lpires211002/CHIDORI_Proyecto_final_de_carrera/Escrito PFC/figuras/bode_cadena.pdf

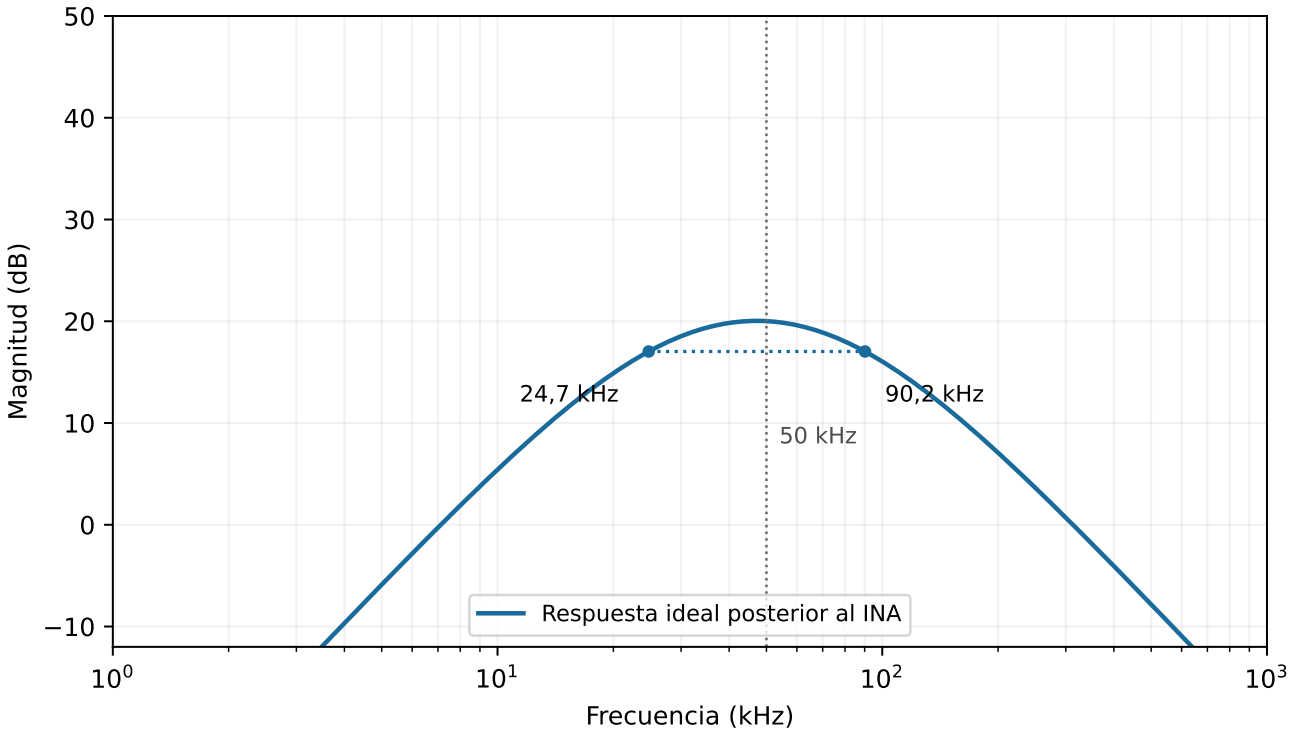
[picture p54: figure]
Frecuencia (kHz); Magnitud (dB); 24,7 kHz; 90,2 kHz; 50 kHz; Respuesta ideal; posterior al INA
