lpires211002/CHIDORI_Proyecto_final_de_carrera/Analisis_EDA/salidas/figuras/caida_por_sujeto.png

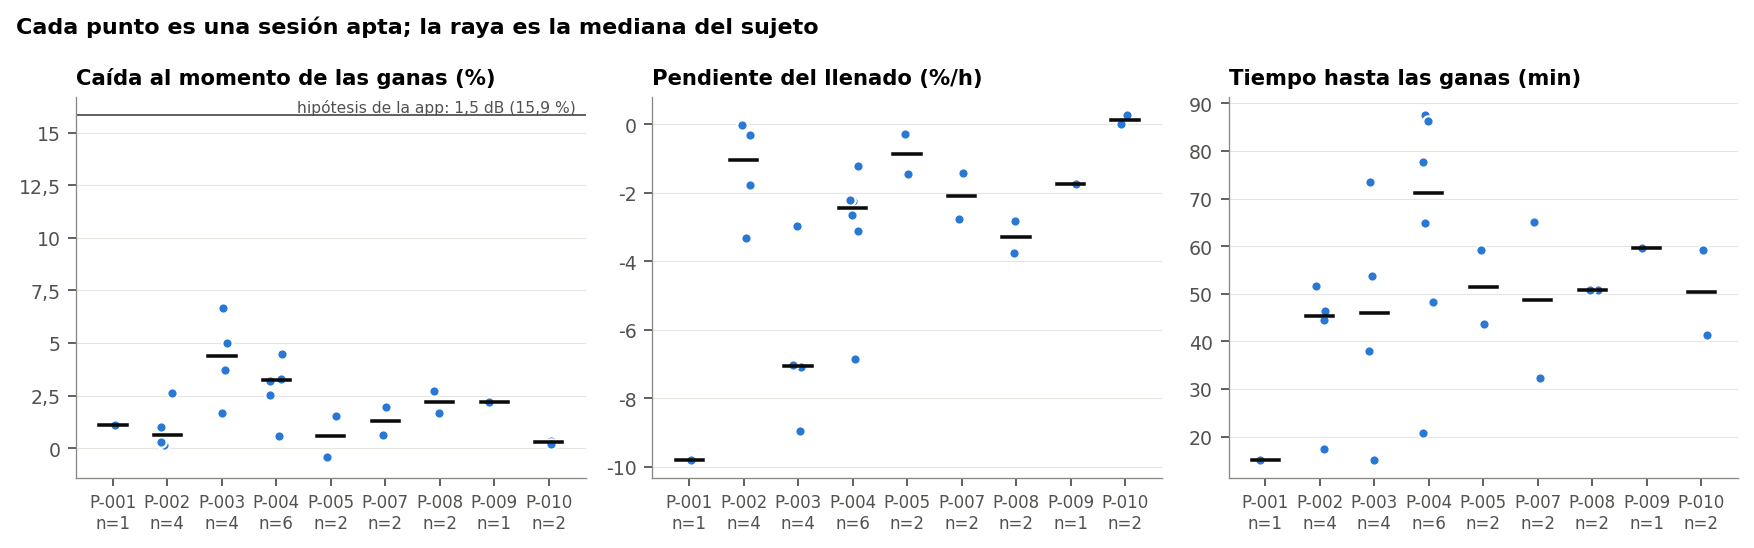
Analisis_EDA/salidas/figuras/caida_por_sujeto.png
