lpires211002/CHIDORI_Proyecto_final_de_carrera/Analisis_EDA/salidas/figuras/respuesta_tomas.png

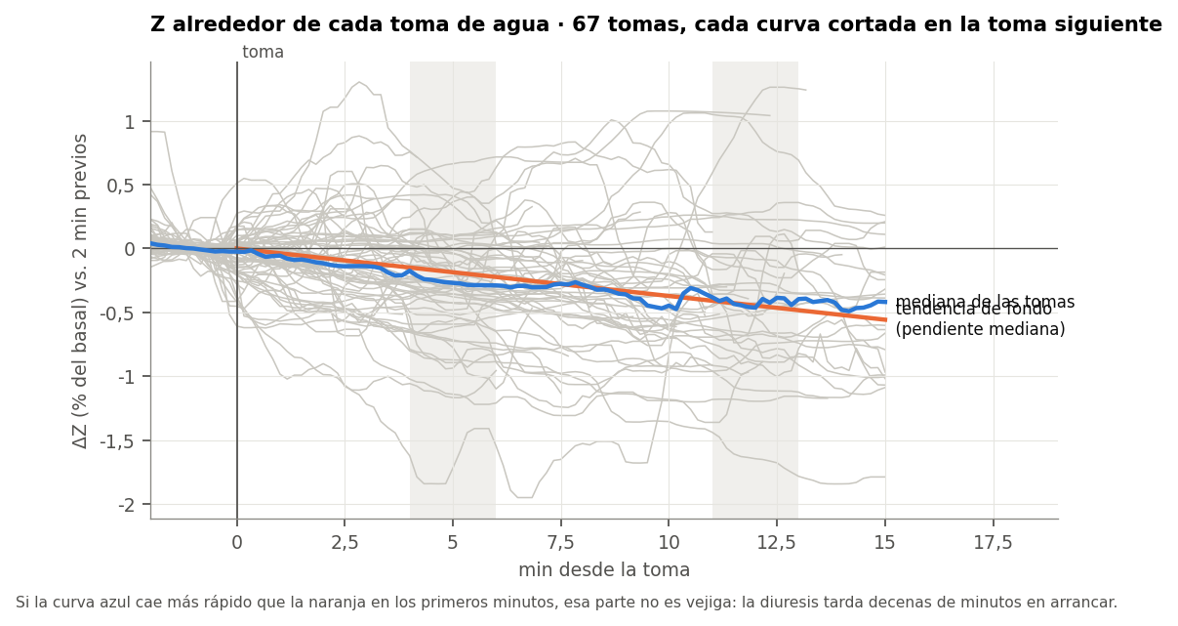
Analisis_EDA/salidas/figuras/respuesta_tomas.png
