lpires211002/CHIDORI_Proyecto_final_de_carrera/Analisis_EDA/salidas/figuras/sesiones/sesion_P-002_s05.png

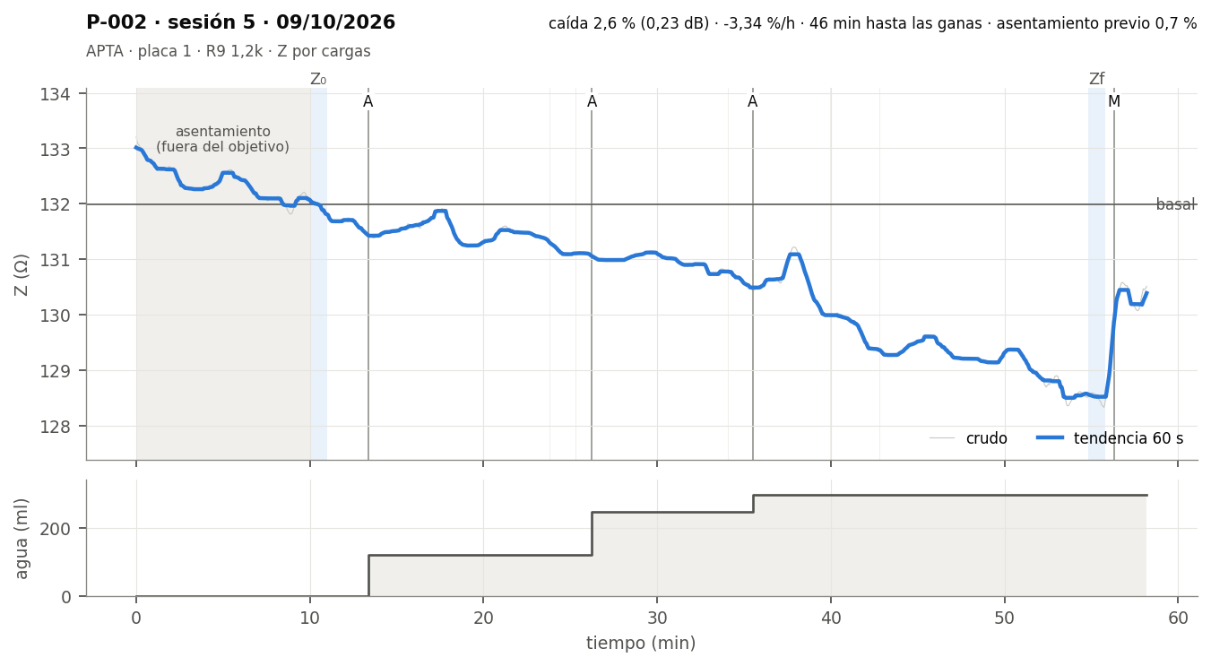
Analisis_EDA/salidas/figuras/sesiones/sesion_P-002_s05.png
