lpires211002/CHIDORI_Proyecto_final_de_carrera/Analisis_EDA/salidas/figuras/sesiones/sesion_P-004_s11.png

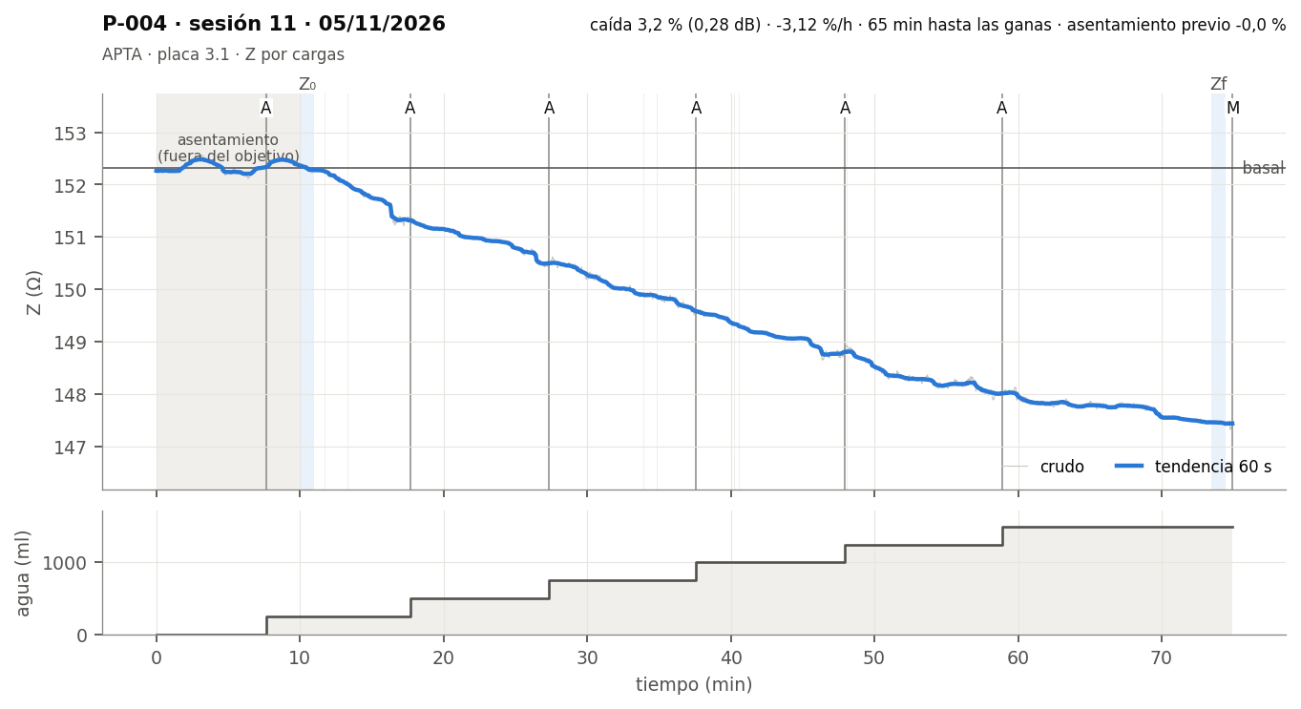
Analisis_EDA/salidas/figuras/sesiones/sesion_P-004_s11.png
