lpires211002/CHIDORI_Proyecto_final_de_carrera/Analisis_EDA/salidas/figuras/sesiones/sesion_P-004_sin_nro_95b01478.png

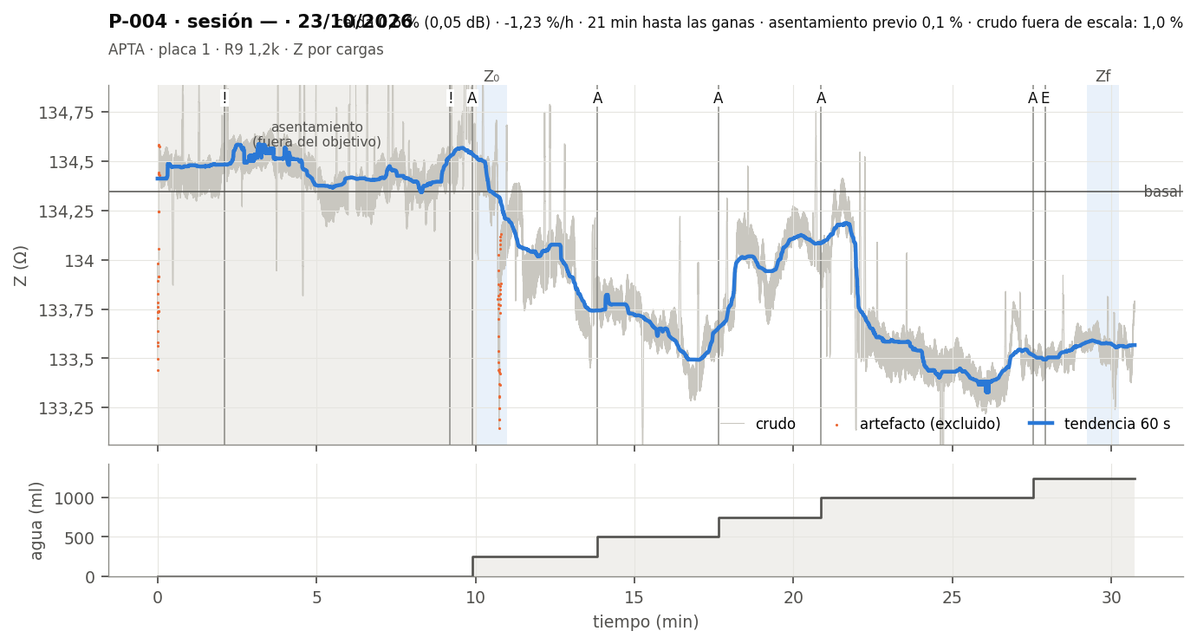
Analisis_EDA/salidas/figuras/sesiones/sesion_P-004_sin_nro_95b01478.png
