lpires211002/CHIDORI_Proyecto_final_de_carrera/Analisis_EDA/salidas/figuras/sesiones/sesion_P-005_s02.png

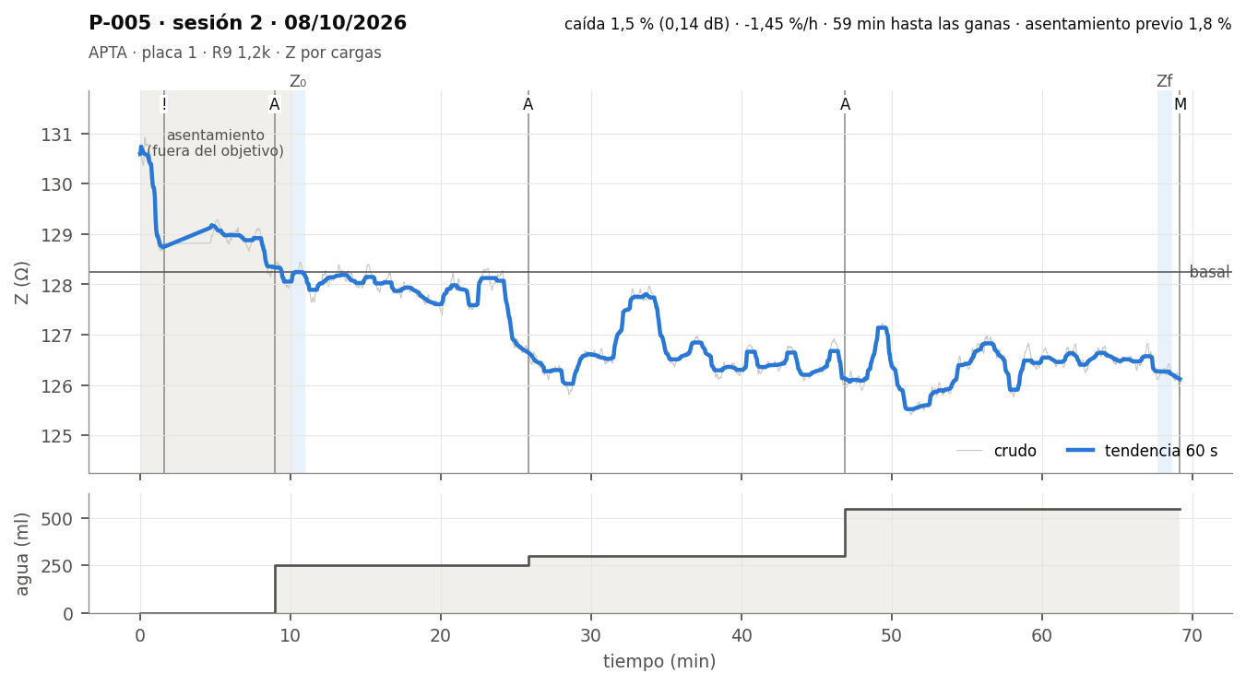
Analisis_EDA/salidas/figuras/sesiones/sesion_P-005_s02.png
