lpires211002/CHIDORI_Proyecto_final_de_carrera/Escrito PFC/diagramabloquespfc2.drawio.png

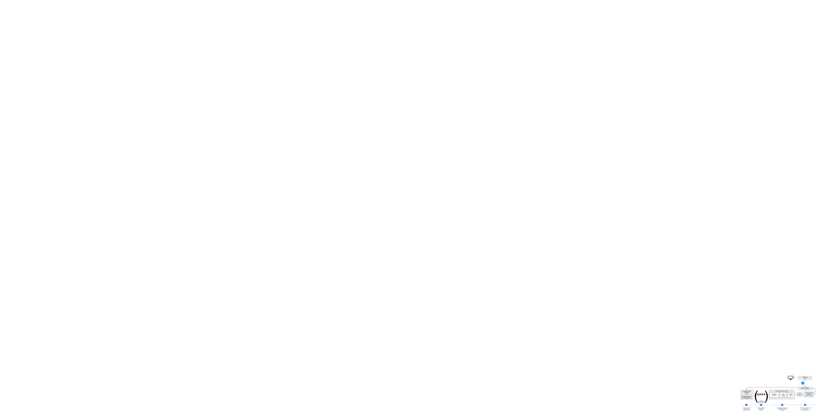
Escrito PFC/diagramabloquespfc2.drawio.png
