lpires211002/CHIDORI_Proyecto_final_de_carrera/Escrito PFC/diagramabloquespfc.drawio.png

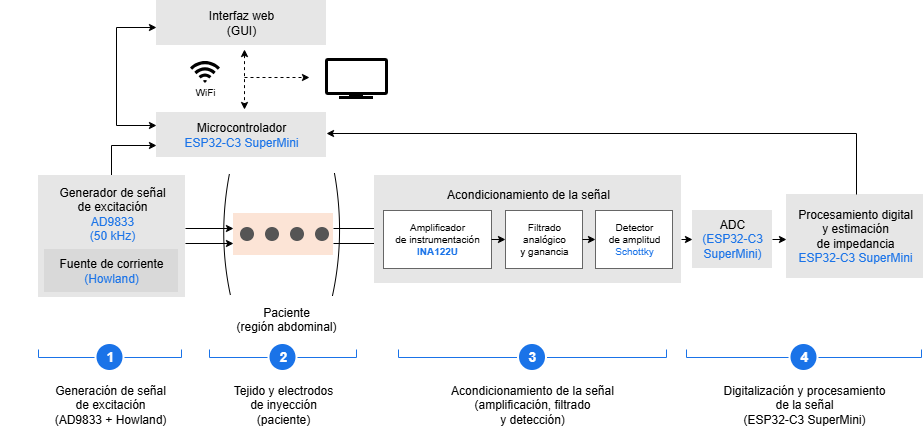
Escrito PFC/diagramabloquespfc.drawio.png
