lpires211002/CHIDORI_Proyecto_final_de_carrera/Escrito PFC/figuras/alrawi2013/realimentacion-corriente.png

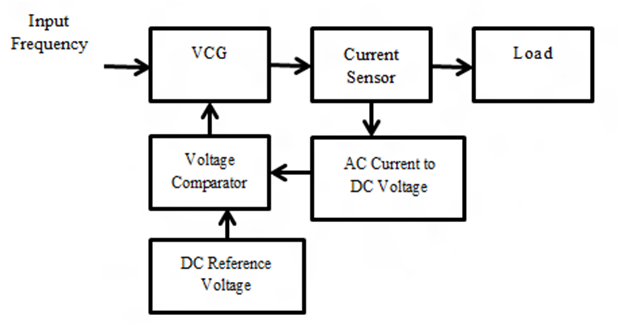
Escrito PFC/figuras/alrawi2013/realimentacion-corriente.png
