lpires211002/CHIDORI_Proyecto_final_de_carrera/Escrito PFC/figuras/bode_acondicionamiento.png

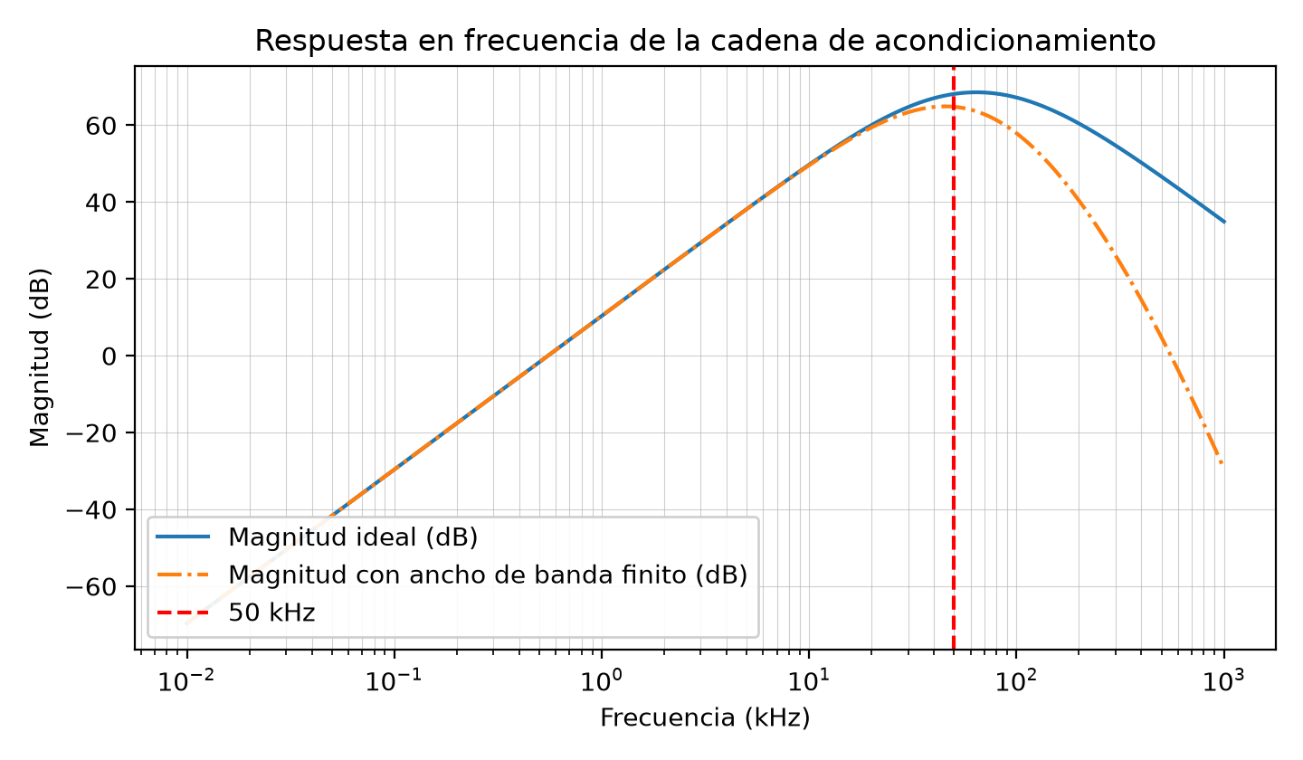
Escrito PFC/figuras/bode_acondicionamiento.png
