lpires211002/CHIDORI_Proyecto_final_de_carrera/Escrito PFC/figuras/bode_cadena.png

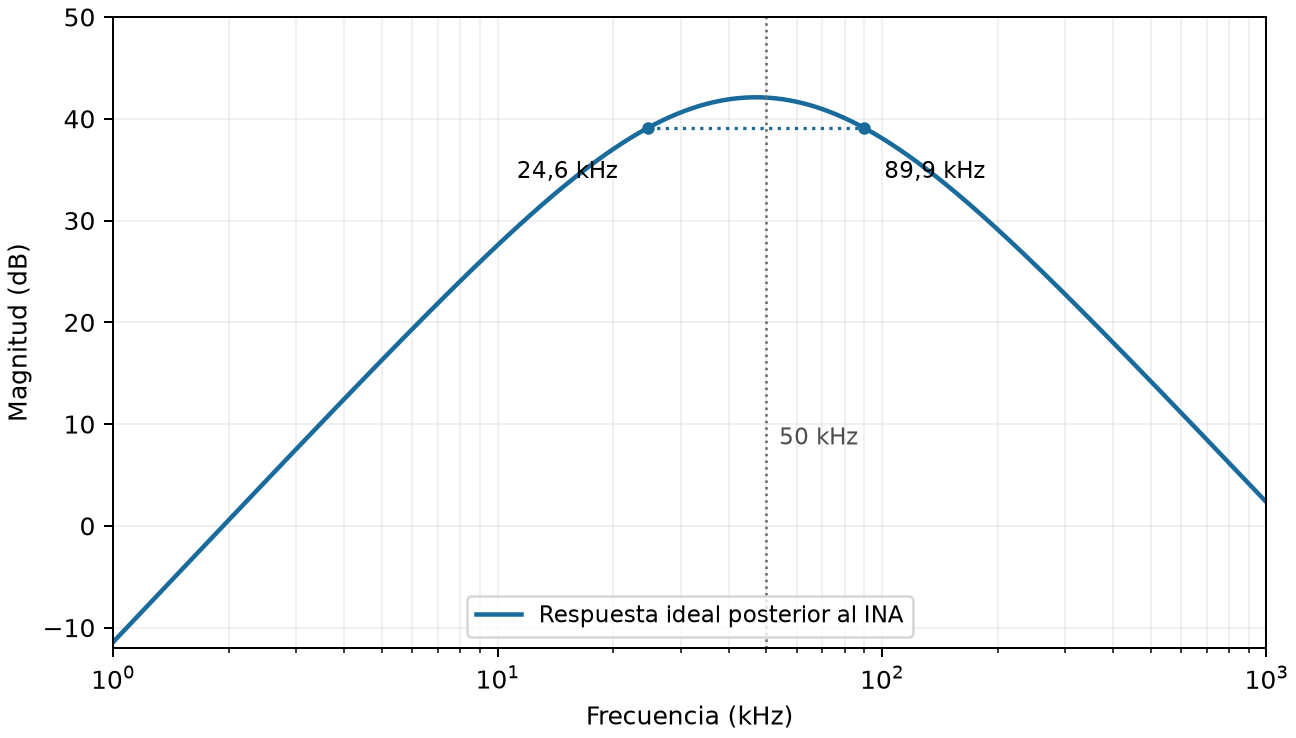
Escrito PFC/figuras/bode_cadena.png
