lpires211002/CHIDORI_Proyecto_final_de_carrera/Escrito PFC/figuras/der_base_datos.png

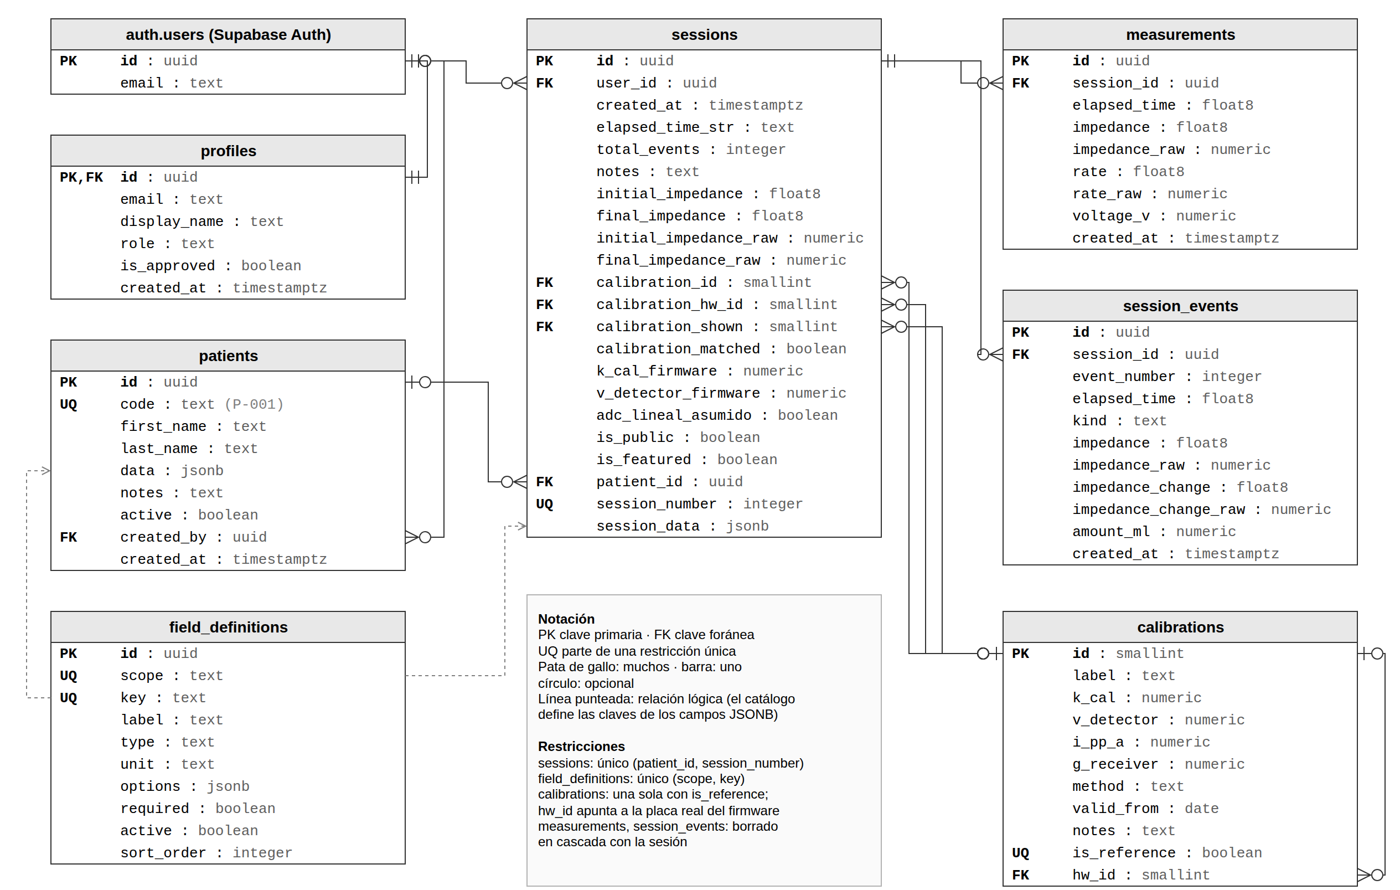
Escrito PFC/figuras/der_base_datos.png
