lpires211002/CHIDORI_Proyecto_final_de_carrera/Escrito PFC/figuras/esquema_preview.png

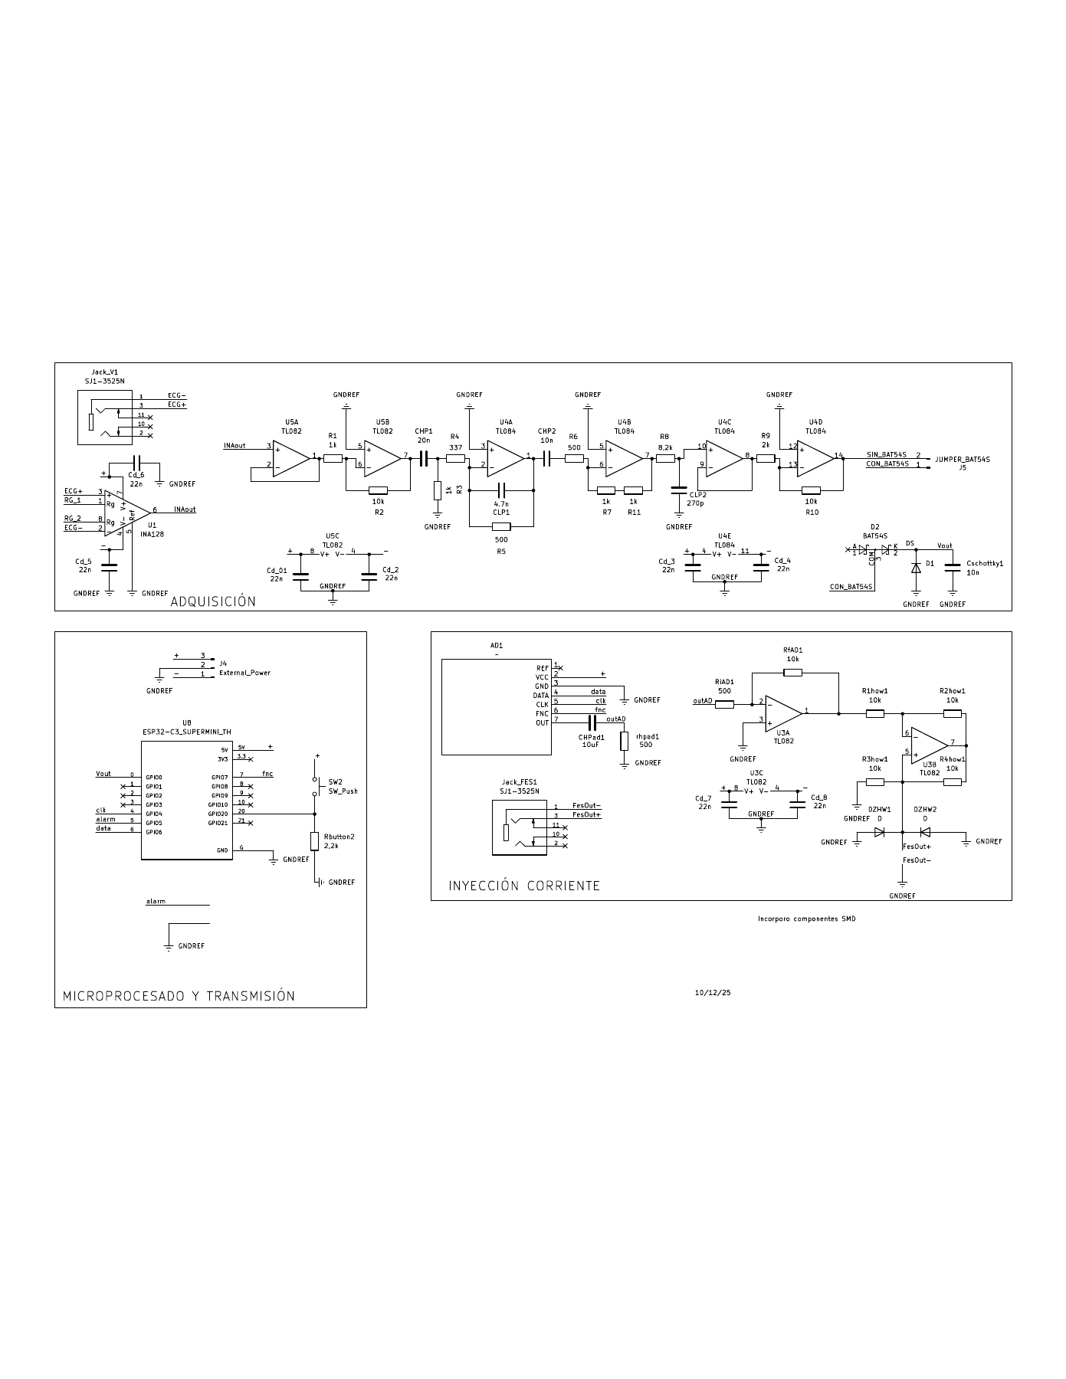
Escrito PFC/figuras/esquema_preview.png
