lpires211002/CHIDORI_Proyecto_final_de_carrera/PCB PFC/BOM_CHIDORI.xlsx

Sheet: BOM SMD (PCBWay)
# | Designadores | Cant. | Valor | Footprint | MPN sugerido (CONFIRMAR) | Notas
1 | CLP1 | 1 | 100p | C_0603 | Samsung CL10C101JB8NNNC | C0G/NP0 50V
2 | CLP2 | 1 | 270p | C_0603 | Samsung CL10C271JB8NNNC | C0G/NP0 50V
3 | CHP2 | 1 | 1.5n | C_0603 | Samsung CL10B152KB8NNNC | X7R 50V
4 | CHP1,Cschottky1 | 2 | 4.7n | C_0603 | Samsung CL10B472KB8NNNC | X7R 50V
5 | Cd_01,Cd_2,Cd_4,Cd_5,Cd_6,Cd_7,Cd_8 | 7 | 22n | C_0603 | Samsung CL10B223KB8NNNC | X7R 50V
6 | CHPad1 | 1 | 10uF | C_0603 | Samsung CL10A106KP8NNNC | X5R - confirmar tension >= alimentacion
7 | R1,R11,R3,R4,R7,R9,RiAD1 | 7 | 1k | R_0805 | Yageo RC0805FR-071KL | 1% 1/8W
8 | R1how1,R2,R2how1,R3how1,R4how1,R8 | 6 | 10k | R_0805 | Yageo RC0805FR-0710KL | 1% 1/8W
9 | Rbutton2 | 1 | 2.2k | R_0805 | Yageo RC0805FR-072K2L | 1% 1/8W
10 | R5 | 1 | 22k | R_0805 | Yageo RC0805FR-0722KL | 1% 1/8W
11 | R10 | 1 | 4.7k | R_0805 | Yageo RC0805FR-074K7L | 1% 1/8W
12 | RfAD1 | 1 | 4.8k | R_0805 | RC0805FR-074K75L (4.75k) | VALOR RARO: 4.8k no existe. Confirmar 4.7k o 4.75k
13 | R6,rhpad1 | 2 | 500 | R_0805 | RC0805FR-07499RL (499R) | VALOR RARO: 500 no estandar. Usar 499R o 510R
14 | U1 | 1 | INA128 | SOIC-8 | TI INA128UA (o INA128U/2K5) | Inst. amp - confirmar MPN exacto
15 | U3,U5 | 2 | TL082 | SOIC-8 | TI TL082CDR | Op-amp dual
16 | U4 | 1 | TL084 | SOIC-14 | TI TL084CDR | Op-amp cuadruple
17 | D2 | 1 | BAT54S | SOT-23 | Diodes BAT54S-7-F | Schottky dual
 | TOTAL | 37

Sheet: THT (vos - NO a PCBWay)
Ref | Descripcion | Cant. | Que comprar / nota
U8 | Modulo ESP32-C3 Supermini | 1 | Comprar modulo ESP32-C3 Supermini (va sobre tiras de pin)
AD1 | Modulo AD9833 / CJMCU-9833 | 1 | Comprar modulo generador DDS AD9833 (CJMCU-9833)
Jack_FES1 | Jack 3.5mm SJ1-3525N | 1 | CUI SJ1-3525N
Jack_V1 | Jack 3.5mm SJ1-3525N | 1 | CUI SJ1-3525N
J4 | Conector alimentacion JST EH 3p | 1 | JST B3B-EH-A (vertical, paso 2.5mm)
J5 | Jumper 1x2 | 1 | Header 1x2 2.54mm + jumper
BZ1 | Buzzer 12mm RM7.6 | 1 | Confirmar activo vs pasivo segun tu circuito
SW2 | Pulsador tactil 6mm | 1 | Push button 6mm THT
D1 | Diodo DO-35 | 1 | VALOR 'DS' poco claro: confirmar (p.ej. 1N4148?)
DZHW1 | Diodo DO-35 | 1 | VALOR 'D' poco claro: confirmar (zener? tension?)
DZHW2 | Diodo DO-35 | 1 | VALOR 'D' poco claro: confirmar (zener? tension?)
