lpires211002/CHIDORI_Proyecto_final_de_carrera/PCB PFC/INA122U-2/INA122U.step

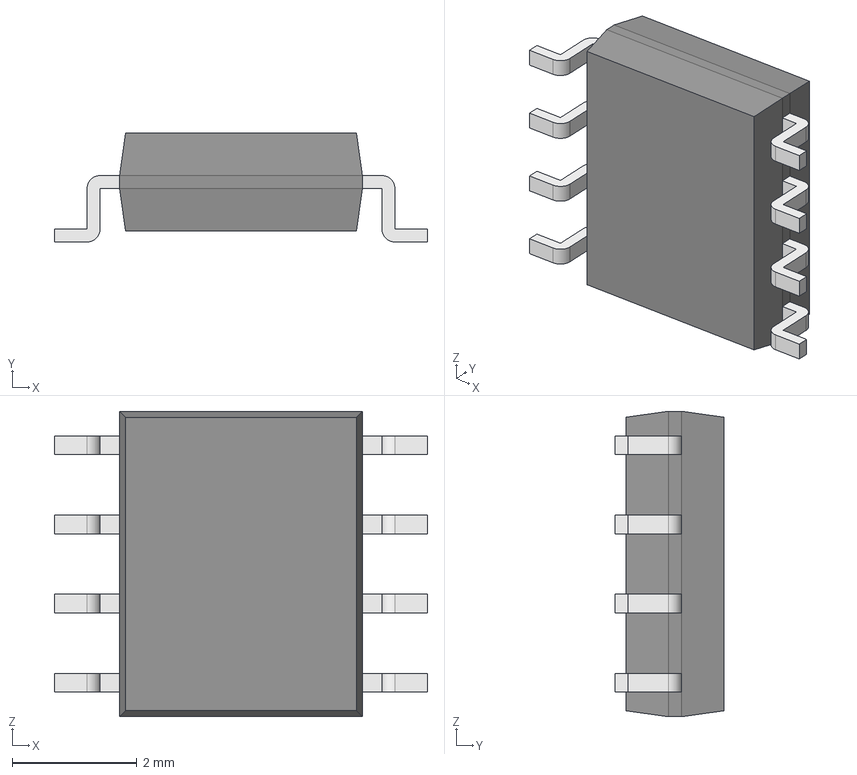
[picture p100: CAD file, 2025-11-30]
PCB PFC/INA122U-2/INA122U.step
5.99 x 1.75 x 4.91 mm
Body001 (Mirror #1) x 4
XY-plane x 12
X-axis x 12
