lpires211002/CHIDORI_Proyecto_final_de_carrera/Analisis_EDA/etiquetas_manuales.csv

session_id | paciente | nro_sesion | fecha | protocolo | sitio | apta | motivo_manual | fin_sesion | t_basal_s | notas_analisis | auto_protocolo | auto_apta | auto_motivos | auto_fin_sesion
dedda0d1-a155-4414-b714-fa066815543b | P-001 | 1 | 2026-08-06 |  |  |  |  |  |  |  | libre | si | cal_no_confirmada | ganas
a0fbf72f-a9fb-41bf-b0b5-ce43bacd0cf8 | P-002 | 1 | 2026-08-02 |  |  |  |  |  |  |  | libre | no | escalones;fin_con_artefactos;posible_prueba;adc_lineal;cal_no_confirmada | ganas
120878ab-8c2c-46b5-9122-46ee4540ab59 | P-002 | 2 | 2026-08-31 |  |  |  |  |  |  |  | libre | si | sin_tomas_registradas;cal_no_confirmada | ganas
f9907666-3603-4faa-a4bf-677e94b35c05 | P-002 | 3 | 2026-10-02 |  |  |  |  |  |  |  | libre | si |  | ganas
e79d53ec-db4d-46ef-b904-1582722755c2 | P-002 | 4 | 2026-10-09 |  |  |  |  |  |  |  | libre | si |  | ganas
ebfc117e-e6e3-48f0-b27e-2be2e4a54d51 | P-002 | 5 | 2026-10-09 |  |  |  |  |  |  |  | libre | si |  | ganas
a08e91ea-60f2-4cb5-9c7c-f09d39bcf85b | P-003 | 1 | 2026-08-15 |  |  |  |  |  |  |  | libre | no | basal_con_artefactos;sin_basal;llenado_corto;sin_tomas_registradas;cal_no_confirmada;muy_corta | ganas
d761b5a1-9ca9-4435-9ab0-fc307bc667e5 | P-003 | 2 | 2026-08-15 |  |  |  |  |  |  |  | libre | no | llenado_corto;cal_no_confirmada | ganas
1c9319bf-26fd-436f-b8fe-de8f2b1d8069 | P-003 | 3 | 2026-08-21 |  |  |  |  |  |  |  | libre | si | sin_tomas_registradas;cal_no_confirmada | ganas
96e77864-f66b-4d30-9c36-46c708f74876 | P-003 | 4 | 2026-08-30 |  |  |  |  |  |  |  | libre | si | sin_tomas_registradas;cal_no_confirmada | ganas
509b2c81-0ebc-4219-80d1-281b79a169f2 | P-003 | 5 | 2026-10-18 |  |  |  |  |  |  |  | libre | si |  | ganas
9b75903e-2d35-45ee-b4c7-bb318242ebbf | P-003 | 6 | 2026-10-30 |  |  |  |  |  |  |  | libre | si |  | ganas
f0827cfe-234e-4d3c-a13f-74073701dff5 | P-003 |  | 2026-07-26 |  |  |  |  |  |  |  | libre | no | sin_tomas_registradas;adc_lineal;cal_no_confirmada | ganas
79758fbc-a7d0-446c-8385-4123ff55b11c | P-004 | 1 | 2026-08-18 |  |  |  |  |  |  |  | libre | si | escalones;basal_con_artefactos;fin_con_artefactos;sin_tomas_registradas;cal_no_confirmada;integridad_baja | ganas
4d7bfcba-5a1a-417a-bb86-5d54055a7391 | P-004 | 5 | 2026-09-02 |  |  |  |  |  |  |  | libre | si | sin_tomas_registradas;cal_no_confirmada | ganas
4570b3e2-c1f8-4a0f-a355-aacb61dfb2c0 | P-004 | 7 | 2026-09-25 |  |  |  |  |  |  |  | libre | si | escalones | ganas
fa2e50e8-252a-4994-aab7-d22f37a2d8a9 | P-004 | 9 | 2026-09-27 |  |  |  |  |  |  |  | libre | si |  | ganas
5765473f-45b0-44d5-93a2-fbe87b1eda4e | P-004 | 10 | 2026-10-08 |  |  |  |  |  |  |  | libre | si |  | ganas
49cced3b-ff9c-4104-9c76-f8ff4bb96db7 | P-004 | 11 | 2026-11-05 |  |  |  |  |  |  |  | libre | si |  | ganas
95b01478-a18f-4ea6-9dd7-b72324e25a7c | P-004 |  | 2026-10-23 |  |  |  |  |  |  |  | libre | si |  | ganas
c27e2bd5-511c-4d4c-accd-2804eb0ab9c9 | P-005 | 1 | 2026-10-08 |  |  |  |  |  |  |  | libre | si |  | ganas
5804c4f6-6fd5-468a-bc45-c8129363ed7c | P-005 | 2 | 2026-10-08 |  |  |  |  |  |  |  | libre | si |  | ganas
2867c98b-8ed6-4346-9ba2-af4adc05e89a | P-006 | 1 | 2026-10-10 |  |  |  |  |  |  |  | libre | no | llenado_corto;muy_corta | ganas
ef2d70cb-c6cf-4ab8-a558-69dcf3c11057 | P-006 | 2 | 2026-10-26 |  |  |  |  |  |  |  | libre | si |  | ganas
f0852f01-d280-4d70-acb5-b8cc4febbf8e | P-007 | 1 | 2026-10-10 |  |  |  |  |  |  |  | libre | si |  | ganas
02ce5364-1276-4bb8-9cee-ba1e887510cd | P-007 | 3 | 2026-10-18 |  |  |  |  |  |  |  | libre | si |  | ganas
fc52a3be-a132-4365-924c-0b371e5f183a | P-008 | 1 | 2026-10-15 |  |  |  |  |  |  |  | libre | si |  | ganas
54be7662-83ef-42ab-85a3-3e46b8d3f2d4 | P-008 | 3 | 2026-10-24 |  |  |  |  |  |  |  | libre | si |  | ganas
21d20758-d9a3-4d25-80ad-712a764d2d04 | P-008 | 4 | 2026-10-28 |  |  |  |  |  |  |  | libre | no | llenado_corto | ganas
8a706da8-0d33-495f-a0dd-1e379090a9c2 | P-009 | 1 | 2026-10-21 |  |  |  |  |  |  |  | libre | no | duplicada | ganas
be1868dc-03eb-49ad-8cdc-f68b0c234be7 | P-009 | 4 | 2026-10-21 |  |  |  |  |  |  |  | libre | si |  | ganas
a6806f88-9787-4ac0-b927-7ace5e4ca1ae | P-009 | 5 | 2026-11-04 |  |  |  |  |  |  |  | libre | si | fin_con_artefactos | ganas
ae20aecf-c65f-4018-aaba-1392ced1a784 | P-010 | 1 | 2026-10-26 |  |  |  |  |  |  |  | libre | si |  | ganas
03d236cb-49d3-4edf-a545-cf1af9c8d1fd | P-010 | 2 | 2026-11-04 |  |  |  |  |  |  |  | libre | si |  | ganas
