lpires211002/CHIDORI_Proyecto_final_de_carrera/Programacion_UI_Micro/UI_VIEJA/PRUEBA_UI/1. Prueba_inicial/index.html

⚡

# Chidori

Inactivo

## Control de Mediciones

Monitoreo de bioimpedancia en tiempo real

▶ Iniciar Mediciones 📍 Marcar Evento ↻ Reiniciar ⬇ Descargar Datos

Valor Inicial

Ω

Valor Actual

Ω

Tiempo Transcurrido

00:00

min:seg

Eventos Marcados

0

marcadores

## Gráfica de Impedancia

Módulo de impedancia vs tiempo

⚙️ Configuración de Alarmas ›

Activar sistema de alarmas

Valor absoluto de impedancia

Porcentaje del valor inicial

Diferencia respecto al inicial

## Información del Paciente

×

Nombre Completo

Edad

Sexo

Masculino Femenino

Peso (kg)

Altura (m)

Circunferencia Suprailíaca (cm)

Tiempo desde la última menstruación

Descargar solo mediciones ⬇ Descargar con datos completos
