lpires211002/CHIDORI_Proyecto_final_de_carrera/Escrito PFC/figuras/resultados_medicion_circuito.pdf

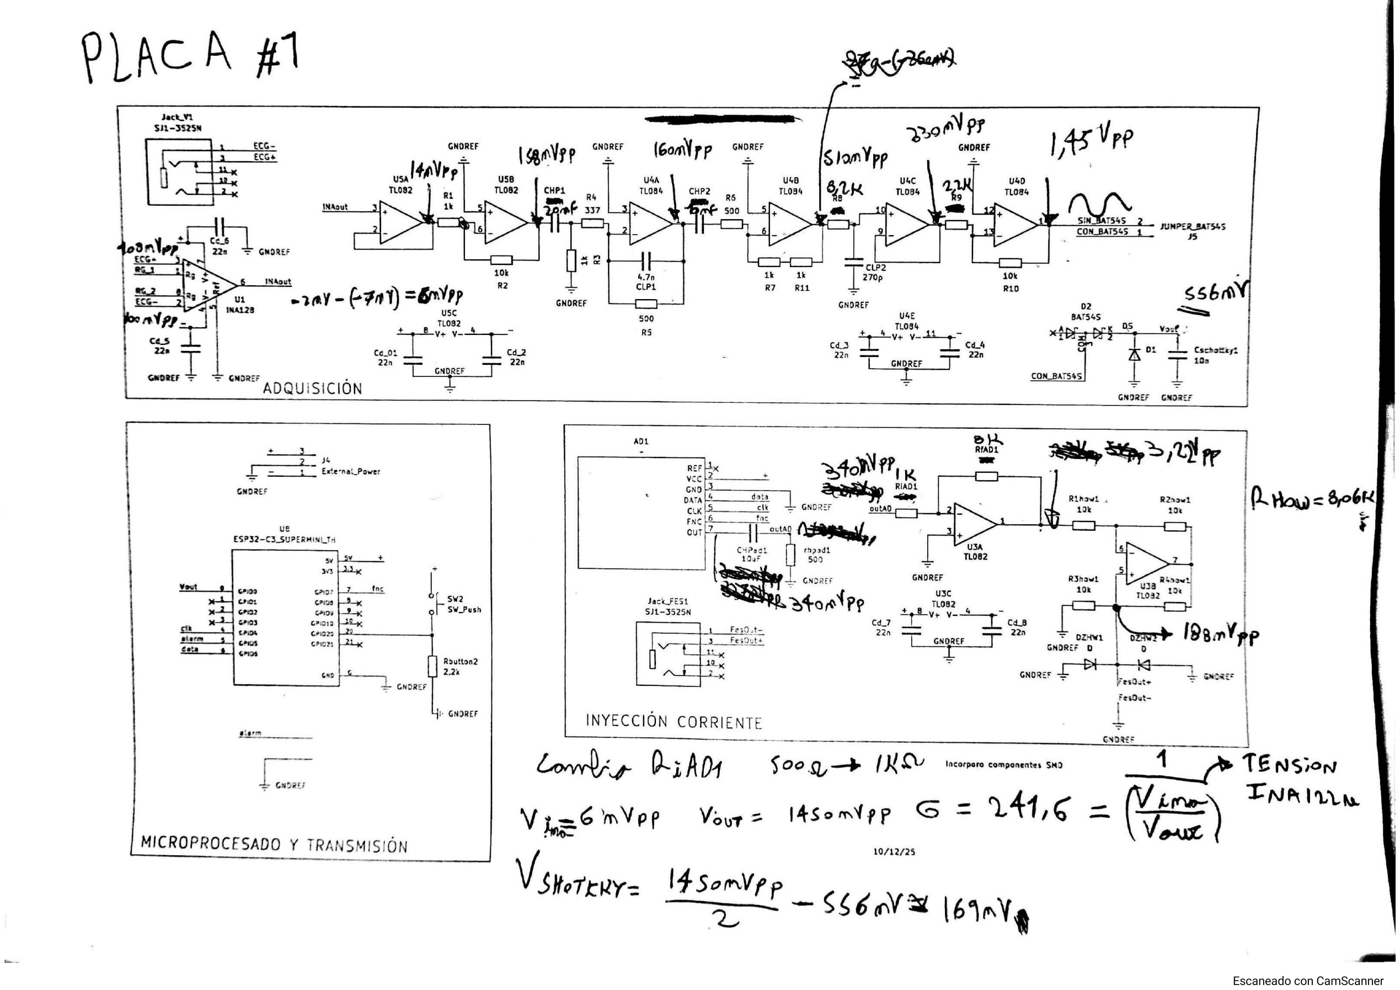
[picture p101: page 1]
