lpires211002/CHIDORI_Proyecto_final_de_carrera/Escrito PFC/figuras/cargas_respuesta.pdf

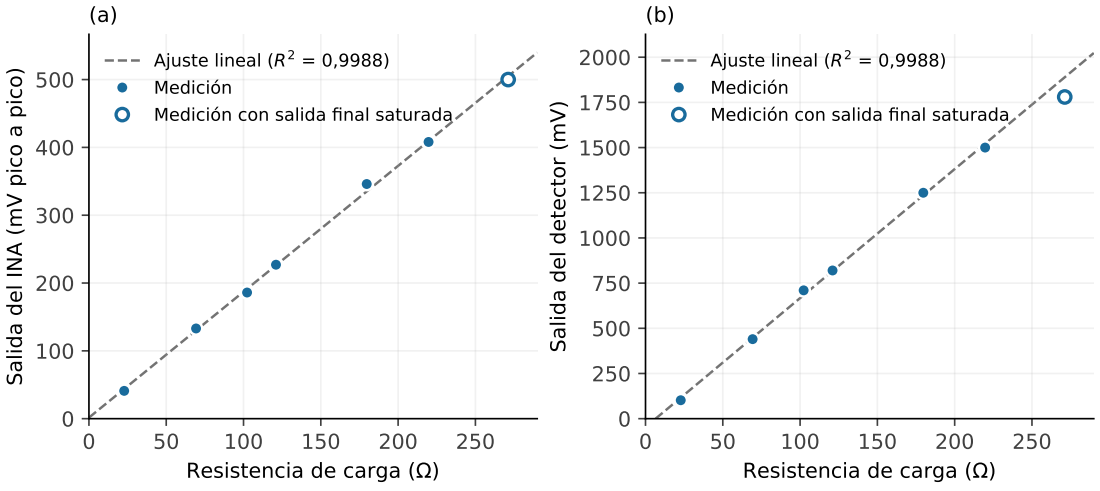
[picture p102: page 1]
Ajuste lineal (R

Salida del INA (mV pico a pico)

Medición
Medición con salida final saturada

Salida del detector (mV)

Resistencia de carga (Ω)
