lpires211002/CHIDORI_Proyecto_final_de_carrera/Escrito PFC/placadef1.pdf

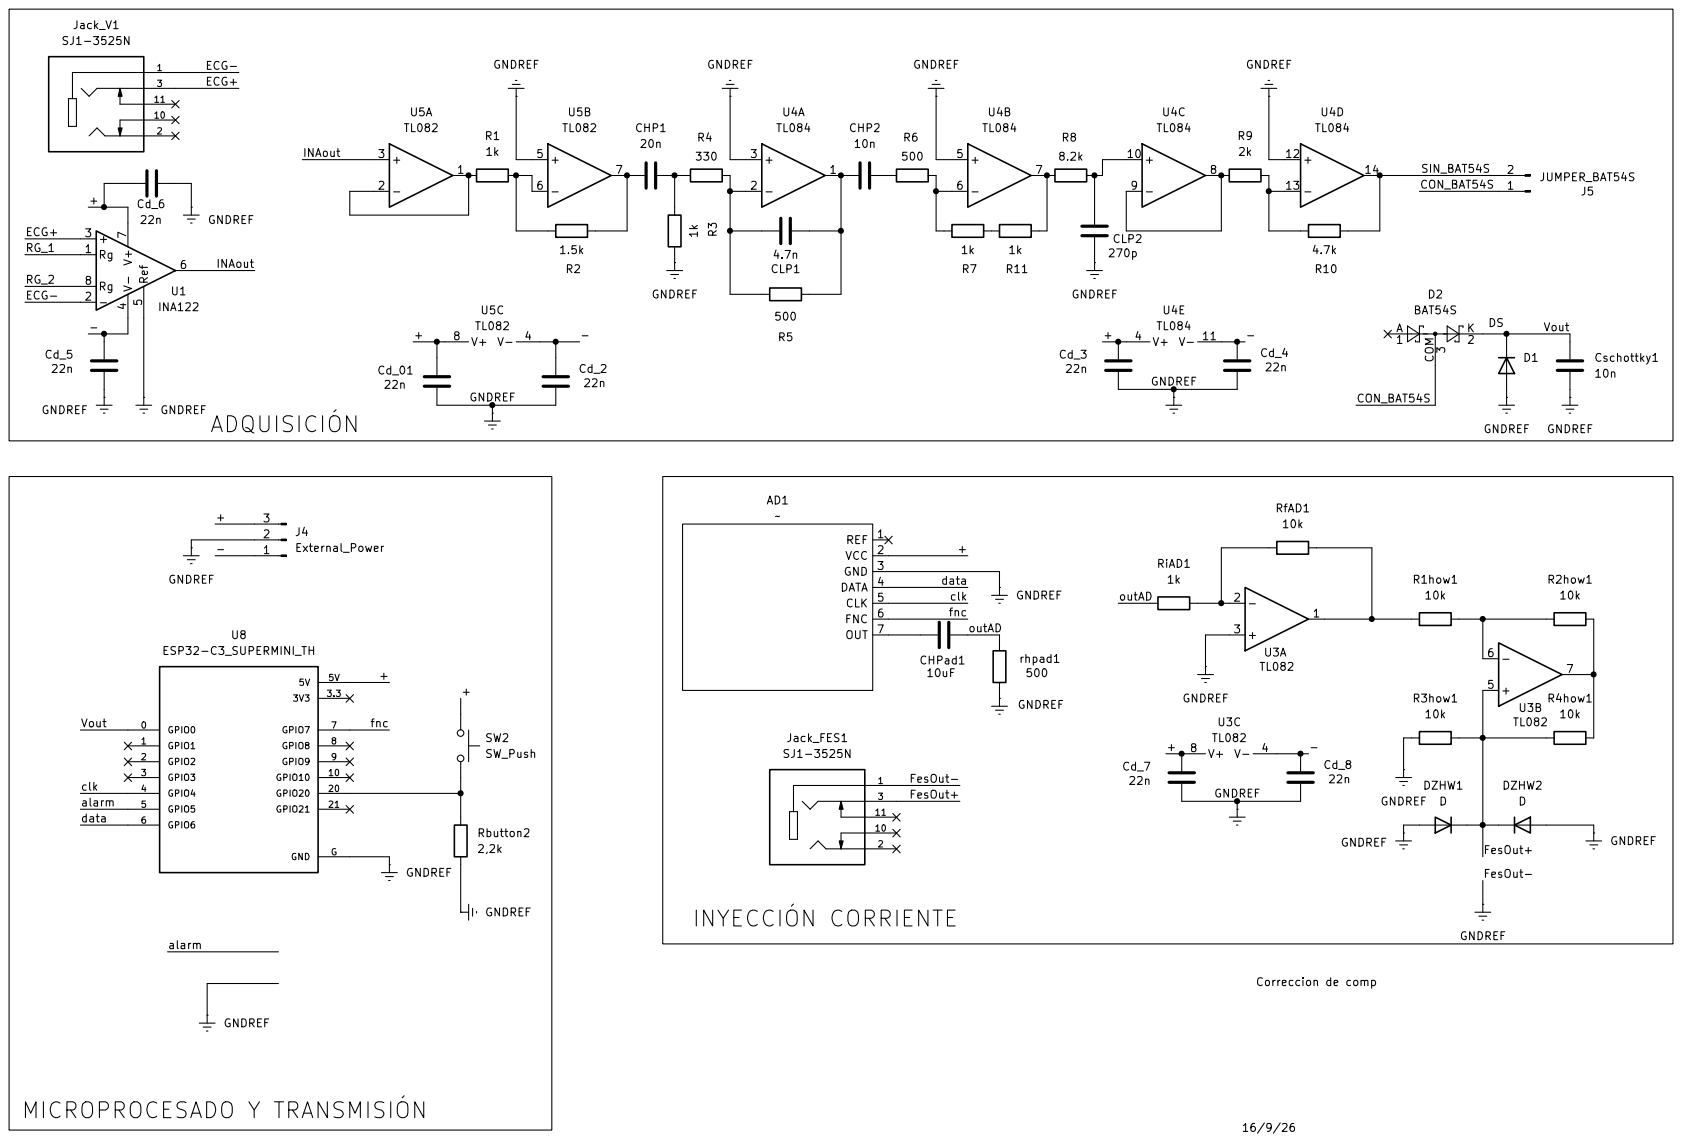
[picture p103: page 1]
