lpires211002/CHIDORI_Proyecto_final_de_carrera/Escrito PFC/figuras/electrodos_posicion.pdf

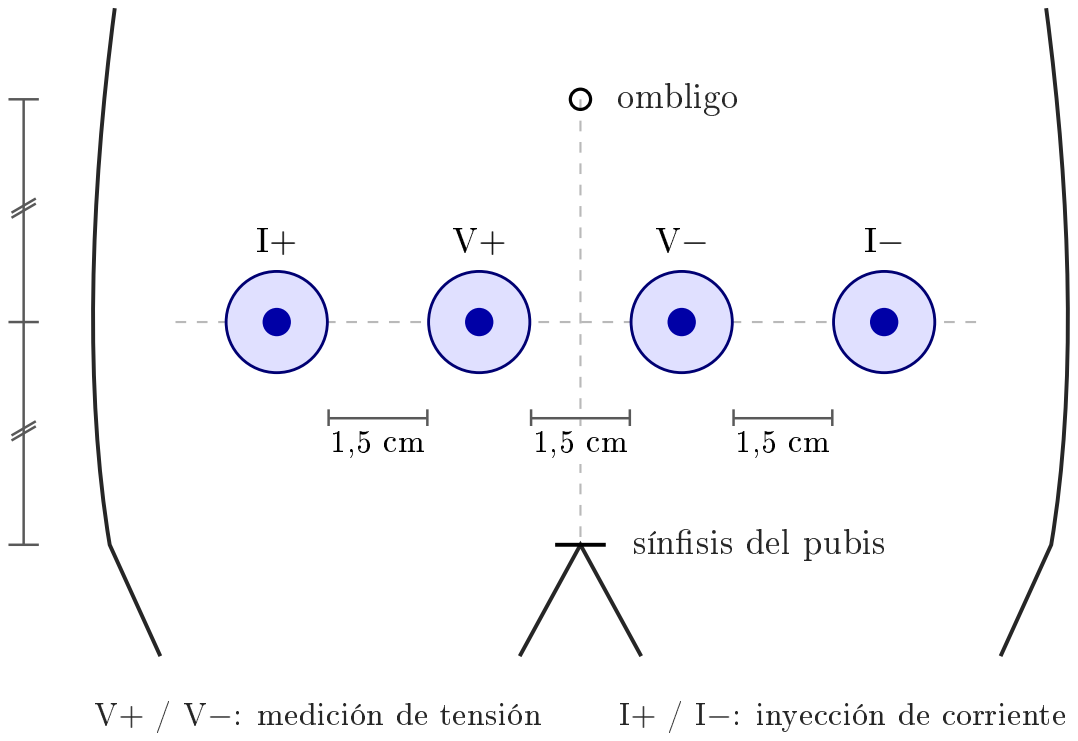
[picture p104: page 1]
ombligo; V+ / V−: medición de tensión; I+ / I−: inyección de corriente

sínsis del pubis
