lpires211002/CHIDORI_Proyecto_final_de_carrera/Escrito PFC/figuras/esquema_circuito.pdf

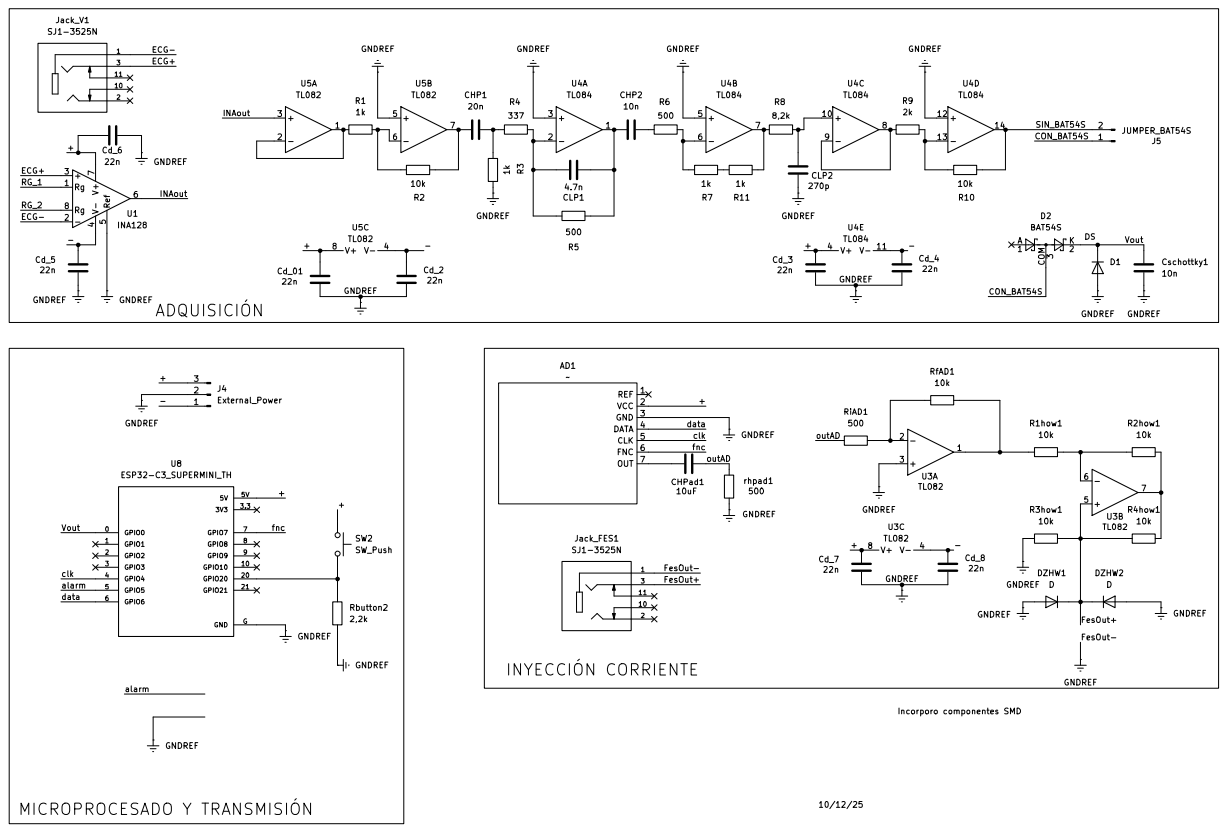
[picture p105: page 1]
