lpires211002/CHIDORI_Proyecto_final_de_carrera/LTspice/Filtrado actual.asc

C1: Cap; 4.7n
C2: Cap; 4.7n
C3: Cap; 1.5n
C4: Cap; 270p
C5: Cap; 10n
D1: schottky
R1: Res; 1k
R2: Res; 1k
R3: Res; 510
R4: Res; 500
R5: Res; 2k
R6: Res; 10k
R7: Res; 510
R8: Res; 16.2k
R9: Res; 1k
R10: Res; 0
R11: Res; 10k
R12: Res; 510
R13: Res; 22k
R14: Res; 10k
R15: Res; 10k
R16: Res; 10k
R17: Res; 10k
R18: Res; 10k
U1: LT1057
U2: LT1057
U3: LT1057
U4: LT1057
U5: LT1057
U6: LT1057
U7: LT1057
V1: Voltage; SINE(0 0.0010 50k)
V2: Voltage; 3.7
V3: Voltage; 3.7
V4: Voltage; SINE(0 0.75 50k)
Named nets: 0, a, b
.tran 1ms
