lpires211002/CHIDORI_Proyecto_final_de_carrera/LTspice/Idea Filtrado.asc

C5: Cap; 4.7n
C6: Cap; 100p
C7: Cap; 1.5n
C8: Cap; 270p
C17: Cap; 100n
C18: Cap; 100p
C19: Cap; 1.8n
C20: Cap; 220p
C21: Cap; 4.7n
C22: Cap; 1n
D1: schottky
D2: schottky
R1: Res; 10k
R12: Res; 1k
R13: Res; 1k
R14: Res; 22k
R15: Res; 500
R16: Res; 2k
R17: Res; 10k
R18: Res; 1k
R19: Res; 4.7k
R21: Res; 1k
R22: Res; 2.2k
R31: Res; 50
R37: Res; 1k
R38: Res; 22k
R39: Res; 500
R40: Res; 2.2k
R41: Res; 11k
R42: Res; 1k
R43: Res; 4k
R44: Res; 10k
R45: Res; 1k
R46: Res; 2.2k
U7: LT1057
U8: LT1057
U9: LT1057
U10: LT1057
U11: LT1057
U12: LT1057
U19: LT1057
U20: LT1057
U21: LT1057
U22: LT1057
U23: LT1057
U24: LT1057
V1: Voltage; SINE(0 0.15 3)
V5: Voltage; SINE(0 0.15 50k)
V6: Voltage; 3.7
V7: Voltage; 3.7
V9: Voltage; SINE(0 6m 50k)
V12: Voltage; SINE(0 2m 10k)
Named nets: 0, a, b
.tran 100ms
