lpires211002/CHIDORI_Proyecto_final_de_carrera/PCB PFC/PCB PFC.kicad_pcb

## KiCad design PCB PFC/PCB PFC.kicad_pcb (2026-06-26)

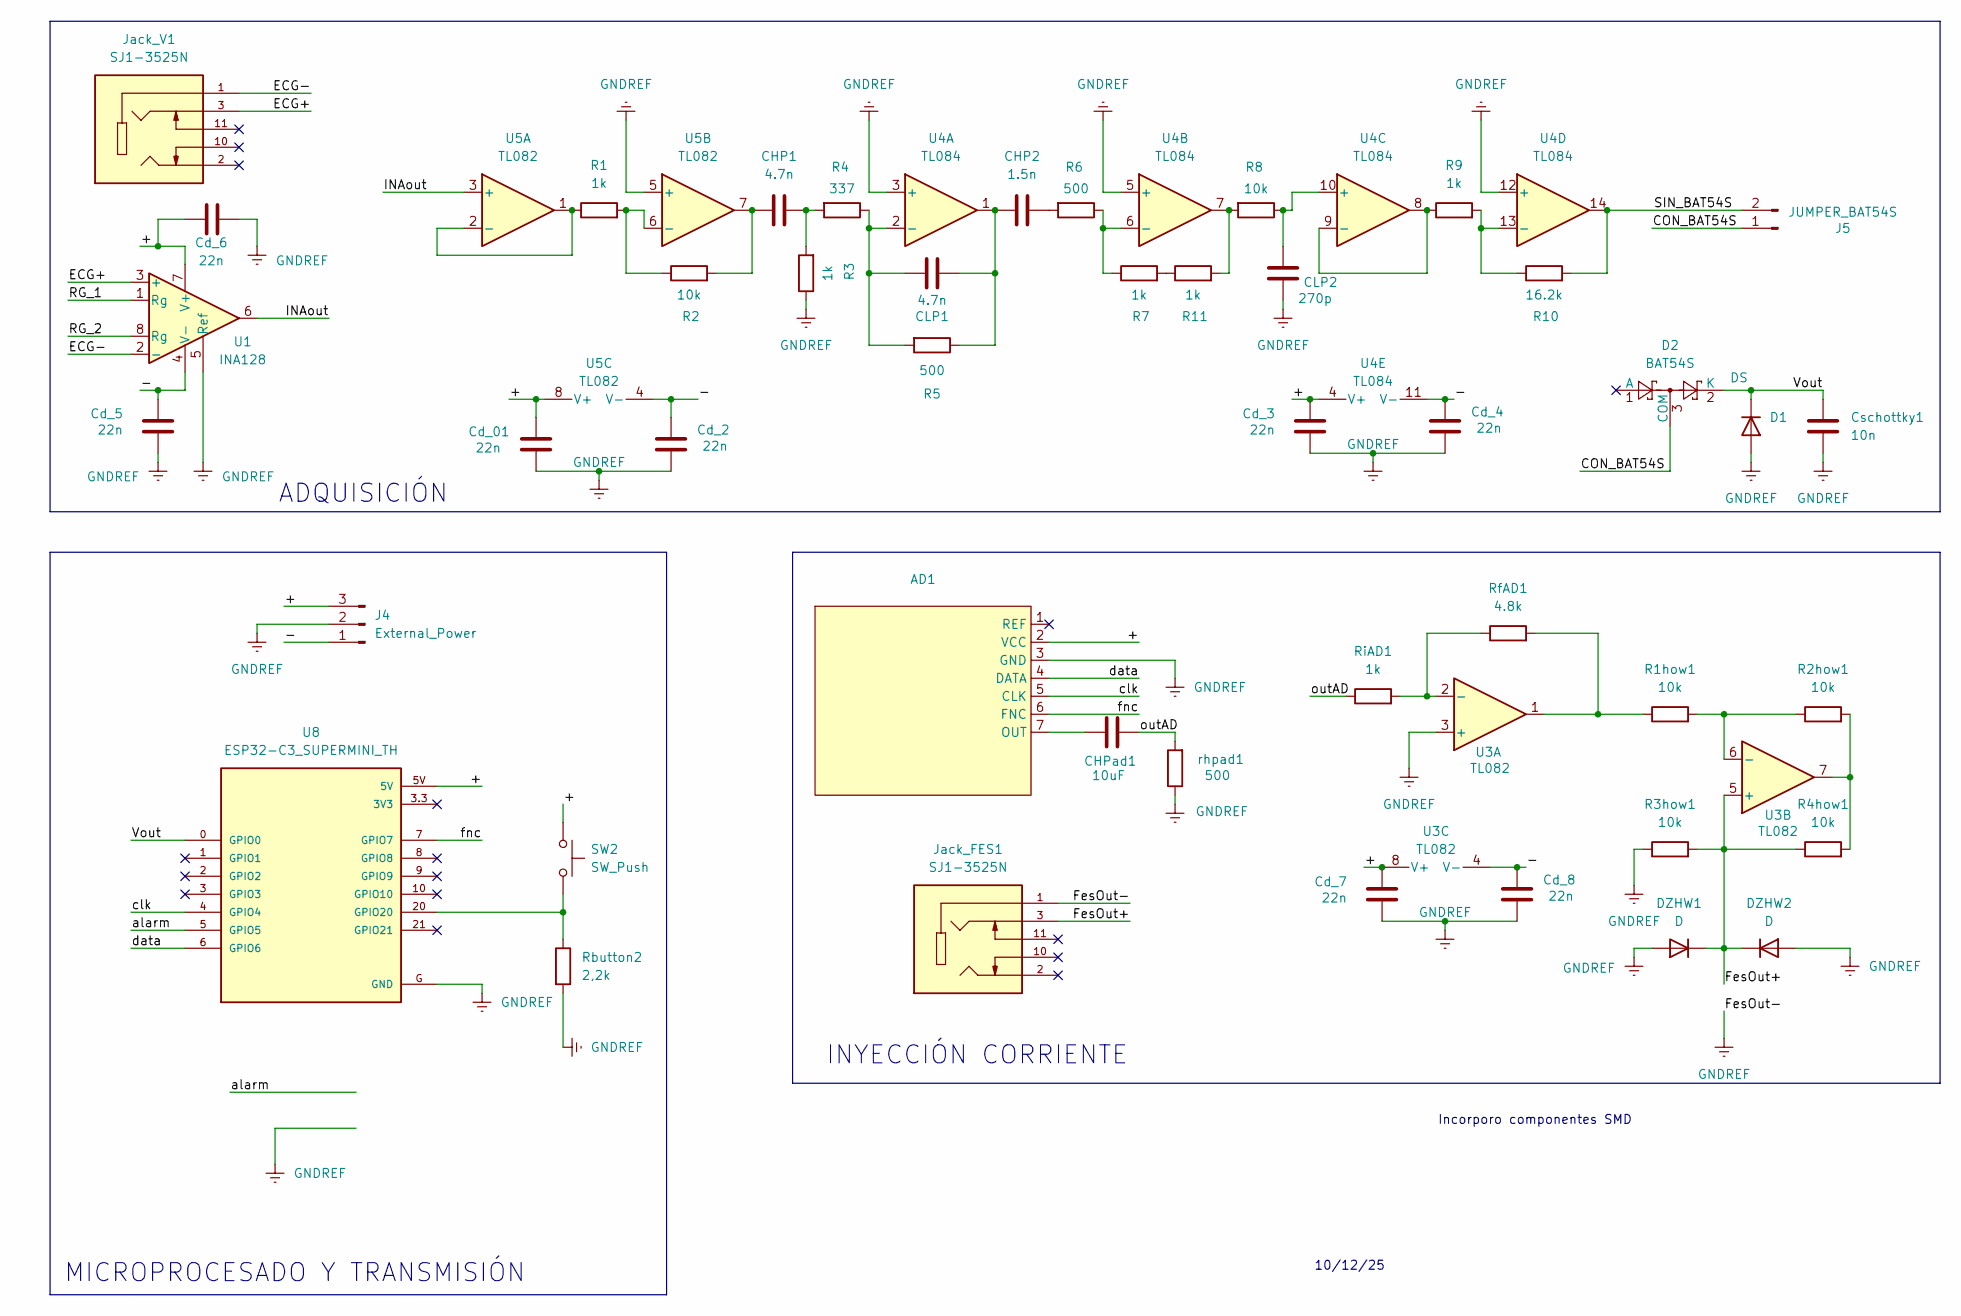
[picture p106: schematic PCB PFC.kicad_sch]

Parts:
AD1: AD9833
CHP1: 4.7n; C_0603_1608Metric
CHP2: 1.5n; C_0603_1608Metric
CHPad1: 10uF; C_0603_1608Metric
CLP1: 4.7n; C_0603_1608Metric
CLP2: 270p; C_0603_1608Metric
Cd_01, Cd_2, Cd_3, Cd_4, Cd_5, Cd_6, Cd_7, Cd_8: 22n; C_0603_1608Metric
Cschottky1: 10n; C_0603_1608Metric
D1: DS; D_DO-35_SOD27_P7.62mm_Horizontal
D2: BAT54S; SOT-23
DZHW1, DZHW2: D; D_DO-35_SOD27_P7.62mm_Horizontal
J4: External_Power; JST_EH_B3B-EH-A_1x03_P2.50mm_Vertical
J5: JUMPER_BAT54S; PinSocket_1x02_P2.54mm_Vertical
Jack_FES1: SJ1-3525N; CUI_SJ1-3525N; PARTREV 1.05
Jack_V1: SJ1-3525N; CUI_SJ1-3525N; PARTREV 1.05
R1, R3, R7, R9, R11: 1k; R_0805_2012Metric
R1how1, R2, R2how1, R3how1, R4how1, R8: 10k; R_0805_2012Metric
R4: 337; R_0805_2012Metric
R5, R6: 500; R_0805_2012Metric
R10: 16.2k; R_0805_2012Metric
Rbutton2: 2,2k; R_0805_2012Metric
RfAD1: 4.8k; R_0805_2012Metric
RiAD1: 1k; R_0805_2012Metric
SW2: SW_Push; SW_PUSH_6mm
U1: INA128; SOIC-8_3.9x4.9mm_P1.27mm
U3, U5: TL082; SOIC-8_3.9x4.9mm_P1.27mm
U4: TL084; SOIC-14_3.9x8.7mm_P1.27mm
U8: ESP32-C3_SUPERMINI_TH; MODULE_ESP32-C3_SUPERMINI_TH
rhpad1: 500; R_0805_2012Metric

Connections:
/+: AD1.2 (VCC), Cd_01.2, Cd_3.2, Cd_6.2, Cd_7.2, J4.3, SW2.1, U1.7 (V+), U3.8 (V+), U4.4 (V+), U5.8 (V+), U8.5V
/-: Cd_2.2, Cd_4.2, Cd_5.2, Cd_8.2, J4.1, U1.4 (V-), U3.4 (V-), U4.11 (V-), U5.4 (V-)
/CON_BAT54S: D2.3 (COM), J5.1
/ECG+: Jack_V1.3, U1.3 (+)
/ECG-: Jack_V1.1, U1.2 (-)
/FesOut+: DZHW1.1 (K), DZHW2.1 (K), Jack_FES1.3, R3how1.2, R4how1.1, U3.5 (+)
/INAout: U1.6, U5.3 (+)
/RG_1: U1.1 (Rg)
/RG_2: U1.8 (Rg)
/SIN_BAT54S: J5.2, R10.2, U4.14
/Vout: Cschottky1.2, D1.1 (K), D2.2 (K), U8.0 (GPIO0)
/alarm: U8.5 (GPIO5); also elsewhere on the board
/clk: AD1.5 (CLK), U8.4 (GPIO4)
/data: AD1.4 (DATA), U8.6 (GPIO6)
/fnc: AD1.6 (FNC), U8.7 (GPIO7)
/outAD: CHPad1.2, RiAD1.1, rhpad1.2
GNDREF: AD1.3 (GND), CLP2.1, Cd_01.1, Cd_2.1, Cd_3.1, Cd_4.1, Cd_5.1, Cd_6.1, Cd_7.1, Cd_8.1, Cschottky1.1, D1.2 (A), DZHW1.2 (A), DZHW2.2 (A), J4.2, Jack_FES1.1, R3.1, R3how1.1, Rbutton2.2, U1.5 (Ref), U3.3 (+), U4.3 (+), U4.5 (+), U4.12 (+), U5.5 (+), U8.G (GND), rhpad1.1; also elsewhere on the board
unnamed: AD1.7 (OUT), CHPad1.1
unnamed: CHP1.1, R2.2, U5.7
unnamed: CHP1.2, R3.2, R4.2
unnamed: CHP2.1, CLP1.2, R5.1, U4.1
unnamed: CHP2.2, R6.2
unnamed: R1how1.1, RfAD1.2, U3.1
unnamed: R2how1.2, R4how1.2, U3.7
unnamed: R7.2, R11.1
unnamed: R8.2, R11.2, U4.7
unnamed: RfAD1.1, RiAD1.2, U3.2 (-)
unnamed: R1how1.2, R2how1.1, U3.6 (-)
unnamed: CLP1.1, R4.1, R5.2, U4.2 (-)
unnamed: R6.1, R7.1, U4.6 (-)
unnamed: CLP2.2, R8.1, U4.10 (+)
unnamed: R9.1, U4.8, U4.9 (-)
unnamed: R9.2, R10.1, U4.13 (-)
unnamed: R1.1, U5.1, U5.2 (-)
unnamed: R1.2, R2.1, U5.6 (-)
unnamed: Rbutton2.1, SW2.2, U8.20 (GPIO20)

Notes on the sheet:
10/12/25
ADQUISICIÓN
Incorporo componentes SMD
MICROPROCESADO Y TRANSMISIÓN
INYECCIÓN CORRIENTE

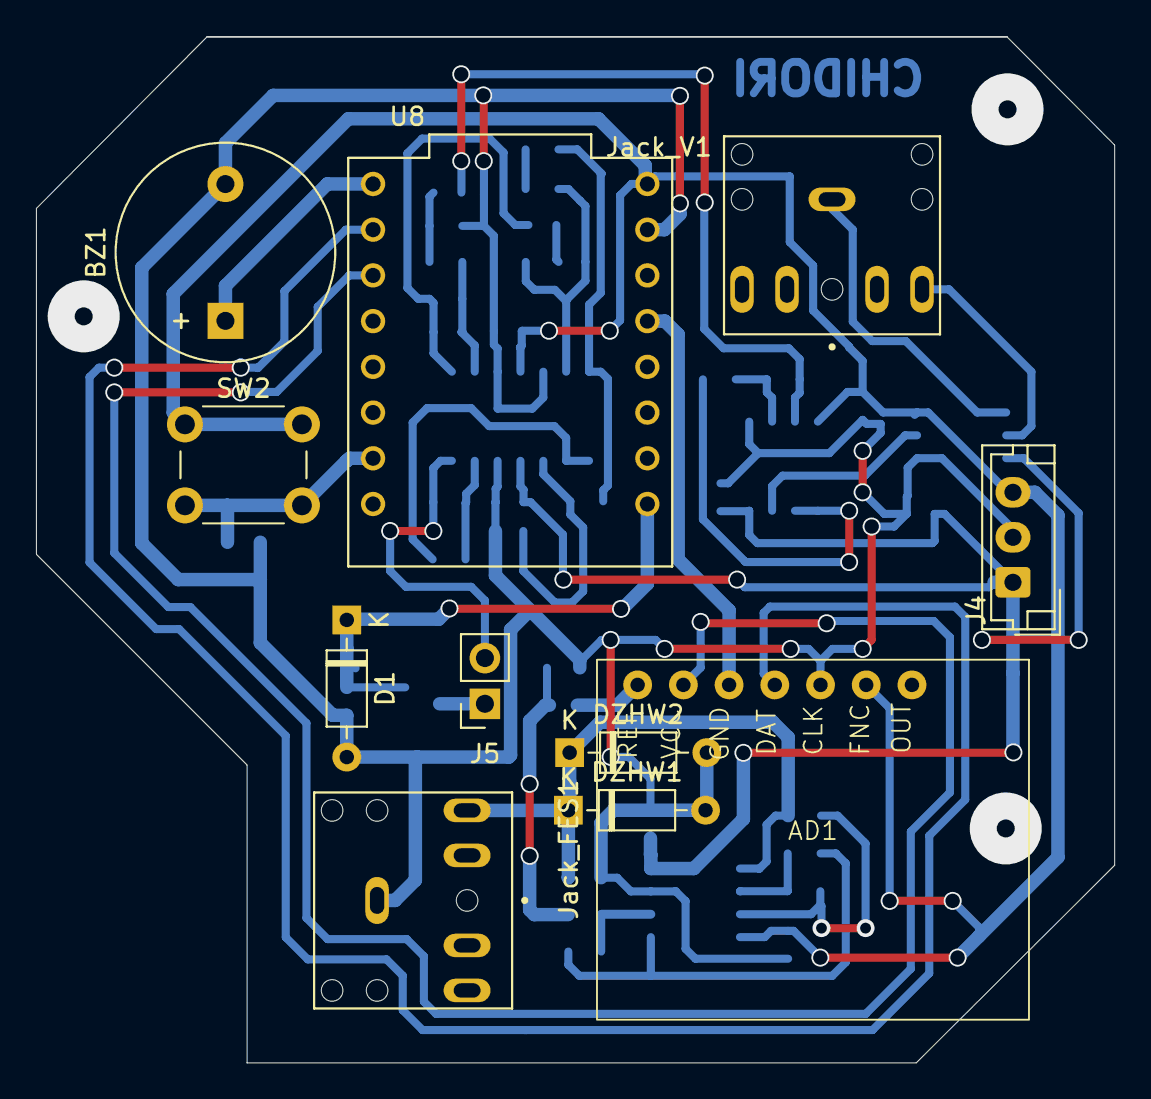
[picture p107: board PCB PFC.kicad_pcb from above]

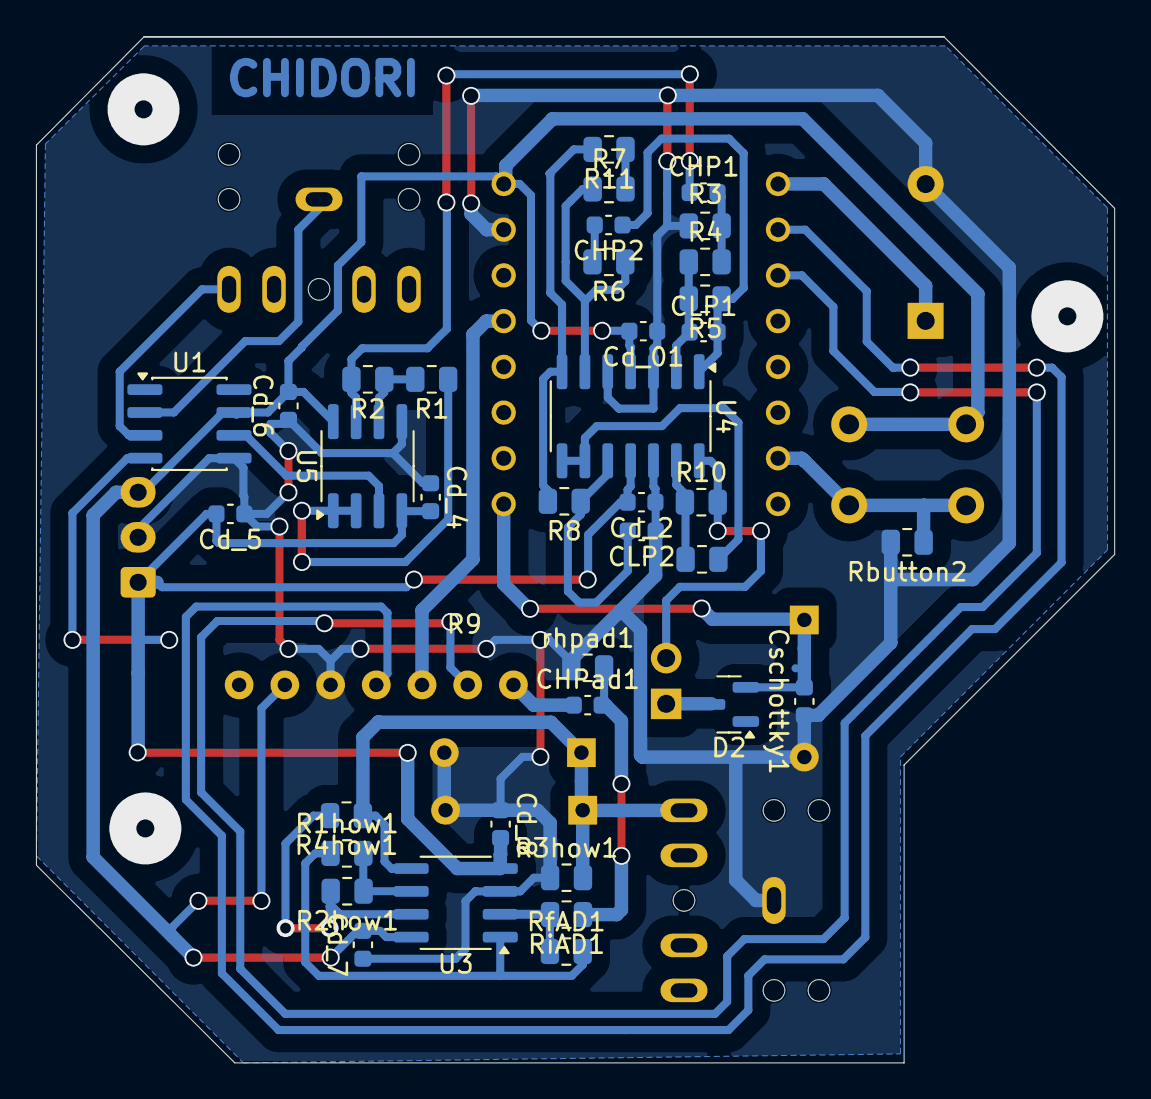
[picture p108: board PCB PFC.kicad_pcb from below]

Board: 2 copper layers, 59.9 x 57.0 mm, 48 parts (37 on the bottom side), 34 nets.

Other parts of the board:
BZ1: Buzzer; Buzzer_12x9.5RM7.6

Their connections:
/alarm: BZ1.1 (+); also elsewhere on the board
GNDREF: BZ1.2 (-); also elsewhere on the board
