lpires211002/CHIDORI_Proyecto_final_de_carrera/Programacion_UI_Micro/Firmware_Optimizado/Chidori_ESP32C3_AP/Chidori_ESP32C3_WiFiManager/Chidori_ESP32C3_WiFiManager.ino

/* =====================  PROYECTO CHIDORI ========================*/
/* =====  ESP32-C3 SUPER MINI · ACCESS POINT · EDICIÓN ROBUSTA  ====*/
//
// Reescritura orientada a confiabilidad de transmisión en tiempo real.
// Cambios clave respecto a la versión anterior:
//
//   1. AD9833 se inicializa ANTES del WiFi (alimentación limpia, igual
//      que el sketch de prueba "soloAD" que siempre anda) y se
//      RE-inicializa en cada START → la senoidal nunca queda colgada.
//   2. Heartbeat WebSocket (ping/pong) → los clientes fantasma que
//      dejan los refresh del navegador se eliminan solos. Sin esto,
//      broadcastTXT se frena llamando a sockets muertos.
//   3. MODO ACCESS POINT: el ESP crea su PROPIA red WiFi ("Chidori"),
//      no depende de ningún router ni hotspot. La Mac se conecta directo.
//      (La versión anterior usaba WiFiManager + portal STA, frágil en el C3.)
//   4. TX power fijado en 8.5 dBm. El ESP32-C3 Super Mini tiene un
//      defecto conocido de matching de antena: a potencia default la
//      señal es errática y el AP "Chidori" cuesta encontrarlo.
//      8.5 dBm es el fix documentado por la comunidad y además evita
//      el brown-out por picos de corriente con cables USB marginales.
//   5. Scheduler de muestreo sin ráfagas: si el loop se atrasa (WiFi
//      reconectando, etc.) se re-sincroniza en vez de disparar N
//      muestras juntas.
//   6. Cero String en el camino crítico → sin fragmentación de heap
//      en sesiones largas.
//   7. Diagnóstico: línea de estado cada 10 s por serial (uptime, RSSI
//      real de la estación, heap, clientes WS), comando WS "STATUS",
//      motivo del último reset al boot (detecta brown-outs en sesiones
//      largas) y log con timestamp de asociación/caída de la Mac al AP.
//   8. Limpieza (ago 2026): eliminado TODO el código muerto de la era
//      STA/WiFiManager (onWiFiEvent de STA nunca registrado, watchdog
//      no-op, globales de backoff sin uso). Cero cambio funcional.
//   9. El mensaje de datos lleva el RELOJ DEL EQUIPO (millis) y un número
//      de SECUENCIA. El frontend ya no timestampea por hora de llegada:
//      la curva queda con el tiempo real de medición aunque el WiFi
//      entregue los datos en ráfagas, y las muestras perdidas se cuentan
//      por salto de secuencia en vez de estimarse por la duración del
//      hueco. Formato: "<Z> <Vpp> <Vadc> <t_ms> <seq>".
//  10. Z pasa a calcularse con una constante de calibracion MEDIDA en banco
//      en vez del producto de ganancias de diseno. Las constantes viejas
//      daban I = 288 uA y G = 200; los valores reales medidos el 2026-09-04
//      son 450 uA y 631. La Z venia sobreestimada ~4,4x en valor absoluto y
//      4,93x en los deltas. Ver el bloque CALIBRACION mas abajo.
//  12. El mensaje STATUS lleva kcal y vdet: la app etiqueta cada sesion
//      con la calibracion que REALMENTE la midio, en vez de suponerla.
//  11. Recalibracion (rev 3, 2026-09-15) tras ajustar la ganancia del
//      Howland y los filtros: K_CAL 0,28406 -> 0,20689 y el deficit del
//      detector 0,277 -> 0,169 V.
//  13. Dos placas, dos calibraciones. El 27/09 se cambio R9 de 2,2k a 1,1k
//      en una placa (U4D x4,5 -> x9,1) y la sesion 9 de P-004 se midio con
//      el firmware todavia en 2,2k: quedo al doble. R9_OHM elige entre rev 3
//      (2,2k, medida) y rev 4 (1,1k, K_CAL x2, derivada). SETEARLO ANTES DE
//      FLASHEAR, segun la placa.
//
// ╔══════════════════════════════════════════════════════════════╗
// ║  ⚠️  CONFIGURACIÓN OBLIGATORIA EN ARDUINO IDE  ⚠️             ║
// ║                                                              ║
// ║  Boards Manager:    esp32 by Espressif Systems ≥ 3.0.0       ║
// ║  Library Manager:   WebSockets by Markus Sattler ≥ 2.4.0     ║
// ║                                                              ║
// ║  Board:                ESP32C3 Dev Module                    ║
// ║  USB CDC On Boot:      ENABLED                               ║
// ║  CPU Frequency:        160MHz (WiFi)                         ║
// ║  Flash Size:           4MB (32Mb)                            ║
// ║  Partition Scheme:     Default 4MB with spiffs               ║
// ╚══════════════════════════════════════════════════════════════╝
//
// USO (siempre igual, sin configurar nada):
//   1. Encender el ESP → crea su propia red WiFi "Chidori"
//      (password: chidori123).
//   2. Desde la Mac, conectarse a esa red WiFi "Chidori".
//   3. Abrir la app apuntando a la IP 192.168.4.1, puerto 81.
//
//   No hay portal, ni red que elegir, ni credenciales que guardar: el ESP
//   ES su propio Access Point y arranca SIEMPRE en 192.168.4.1.
//
// Pines (verificados contra esquemático KiCAD):
//   GPIO 0  → ADC (Vout, detector Schottky)
//   GPIO 4  → SPI SCK   (clk AD9833)
//   GPIO 5  → BUZZER
//   GPIO 6  → SPI MOSI  (data AD9833)
//   GPIO 7  → SPI FSYNC (fnc AD9833)
//   GPIO 20 → BOTÓN     (SW2, pull-down externo 2.2k → activo HIGH)
// ─────────────────────────────────────────────────────────────────

#include <WiFi.h>
#include <ESPmDNS.h>
#include <WebSocketsServer.h>
#include <SPI.h>
#include <stdint.h>
#include <math.h>
#include <esp_wifi.h>     // esp_wifi_ap_get_sta_list → RSSI real de la estación
#include <esp_system.h>   // esp_reset_reason → diagnóstico de reinicios

/* ================= PINES ================= */
#define BUZZER       5
#define BUTTON      20
#define ADC_PIN      0
#define PIN_MOSI     6
#define PIN_SCK      4
#define PIN_FSYNC    7

/* ================= CALIBRACIÓN DE LA CADENA DE MEDICIÓN =================
 *
 * REVISION 3 · banco del 2026-09-15, tras ajustar la ganancia del Howland y
 * los filtros. Todo pico a pico, montaje tetrapolar, placa #1.
 *
 * ESTADO DEL HARDWARE (confirmado por Luca el 16/09):
 *   R1 1k · R2 10k · R3 1k · R4 337 · R5 500 · R6 500 · R7+R11 2k
 *   R8 8,2k · R9 2,2k · R10 10k
 *   CHP1 20 n · CHP2 10 n · CLP1 4,7 n · CLP2 ~470 p (impreso 270 p)
 *   RfAD1 ~9,5k · RiAD1 1k · rhpad1 1k · R_How 10k las cuatro
 *
 * Con esos valores el modelo nodal reproduce la cadena medida dentro del
 * 13 % por etapa y del 4,5 % punta a punta. CLP1 se despejo de la ganancia
 * medida de U4A (da 4,60 n, o sea los 4,7 n del esquematico) y CLP2 de la
 * atenuacion de U4C (da 458 p, no los 270 p impresos: o se cambio, o la
 * lectura de 330 mVpp esta baja).
 *
 * LA BANDA QUEDO BIEN CENTRADA. Con los filtros nuevos el pico esta en
 * 40 kHz y el -3 dB va de 22 a 74 kHz, asi que los 50 kHz caen en zona
 * plana: la ganancia se mueve 8 % ante +-10 % de frecuencia. En la placa
 * anterior el pico estaba en 85 kHz y 50 kHz caia sobre el flanco de
 * subida. Es una mejora real de robustez ante tolerancias y deriva termica.
 *
 * MEDICIONES
 *   salida AD9833 (outAD) ......................  340 mVpp
 *   salida U3A .................................  3,22 Vpp
 *   salida del INA122 (U1 pin 6 = U5A, ya x5) ..   14 mVpp
 *   U4B (U4 pin 7) .............................  510 mVpp
 *   U4C (U4 pin 8) .............................  330 mVpp
 *   salida del ultimo opamp (U4 pin 14) ........ 1450 mVpp
 *   Vadc en A0 .................................  556 mV
 *   FesOut+ (nodo de carga) ....................  188 mVpp
 *
 * DE AHI
 *   I inyectada = V_U3A / R_How = 3,22 / 10000 ........ 322,0 uA pp
 *   ganancia post-INA = 1450 / 14 ..................... 103,6
 *   ganancia total = 5 x 103,6 ........................ 517,9
 *   K_CAL = I x G ..................................... 0,16675
 *   deficit del detector = 1450/2 - 556 ............... 0,169 V
 *   Z de esa medicion ................................. 8,7 ohm
 *
 * LAS CUATRO DEL HOWLAND SON 10 k, NO 8,06 k
 * El 8,06 k de la hoja es una lectura EN CIRCUITO: el ohmetro mide la
 * resistencia en paralelo con todo otro camino que exista entre esas dos
 * puntas, asi que siempre lee de menos. Las resistencias no cambian de valor
 * al conectarlas; cambia lo que ve el instrumento.
 *
 * El camino paralelo, midiendo R1how1 entre la salida de U3A y la entrada -
 * de U3B, es:
 *     U3A out --RfAD1--> U3A(-) --RiAD1--> outAD --rhpad1--> GND
 *     GND --R3how1--> FesOut+ --R4how1--> U3B out --R2how1--> U3B(-)
 * o sea RfAD1 + RiAD1 + rhpad1 + 3x10k. Con RfAD1 ~ 9,5k, RiAD1 = 1k y
 * rhpad1 = 1k eso da 41,5k, y 10k || 41,5k = 8,06k: exactamente lo medido.
 *
 * Triple confirmacion, porque ese mismo despeje pide RfAD1 = 9,55k y la
 * ganancia medida de U3A es 3220/340 = 9,47. Cierran entre si.
 *
 * La transconductancia del Howland usa el valor FISICO de las resistencias
 * (I = Vin/R con las cuatro iguales), no la lectura en circuito. Por eso
 * I = 3,22/10000 = 322 uA y no los 399,5 que salian del 8,06k.
 *
 * Para medir una resistencia en circuito hay que levantar una pata, o medirla
 * fuera de la placa.
 *
 * POR QUE 517,9 Y NO LOS 241,6 DE LA HOJA
 * En la hoja la ganancia total se saco como 1450 mVpp sobre el diferencial
 * medido en los electrodos (-2 mV - (-7 mV) = 5 mVpp, anotado como 6). Ese
 * numero es incompatible con el resto de la propia hoja: con INAout = 14
 * mVpp implicaria una ganancia del INA de 2,8, y el INA122 con Rg abierto da
 * 5 por formula (G = 5 + 200k/Rg). El diferencial real tiene que ser ~2,8
 * mVpp. Restar dos lecturas de pocos mV montadas sobre 100 mVpp de modo
 * comun es la medicion menos confiable de la hoja, asi que la cadena se
 * ancla en INAout, que es una lectura directa, y en la ganancia de catalogo
 * del INA. Si se confirmara el diferencial de 5 mVpp, K_CAL pasaria a
 * 0,1159 y esta medicion daria 12,5 ohm en vez de 7,0.
 *
 * OJO CON EL DETECTOR: el deficit paso de 277 mV (04/09, a 1515 mVpp) a
 * 169 mV (15/09, a 1450 mVpp), a practicamente la misma amplitud. Confirmado
 * que J5 NO se movio, asi que queda sin explicar: una de las dos lecturas de
 * Vadc esta mal. Se toma la del 15/09 y NO el promedio: promediar dos numeros
 * cuando uno es probablemente un error no reduce el error, garantiza estar
 * equivocado por la mitad de la diferencia. Ademas 169 mV es lo esperable de
 * un BAT54S a esta corriente, y es la medicion del hardware actual. Vale
 * 0,64 ohm sobre los 8,7 ohm de esta medicion; lo resuelve la calibracion con
 * patrones, que mide el deficit directo.
 *
 * CADENA COHERENTE: con U4C = 330 mVpp (la hoja decia 830, era 330) cada
 * etapa da algo fisicamente posible. U4C atenua a 0,647, como corresponde a
 * un pasabajos RC seguido de un buffer. Y U4D gana 4,39, que con R10 = 10k
 * pide R9 ~ 2,3k: el "22K" de la hoja es 2,2k. Nada de esto mueve K_CAL, que
 * se toma punta a punta (1450/14), pero ahora la cadena se explica entera.
 *
 * RANGO UTIL: 2,03 ohm (Vadc = 0) a ~26 ohm, donde recorta el TL084 con
 * +-3,7 V. Una lectura pegada al techo es RECORTE, no tejido de alta
 * impedancia; una pegada al piso es senal nula.
 *
 * INCERTIDUMBRE DE ESTA CALIBRACION: ~13 %.
 * La etapa U5B son dos resistencias sin capacitores (R1 1k, R2 10k): su
 * ganancia es 10 por construccion. Medida da 158/14 = 11,29, o sea +12,9 %.
 * Ese es el error real de leer 14 mVpp con el osciloscopio, y se propaga
 * ENTERO a K_CAL porque la cadena se ancla en INAout. En ohms: la medicion
 * de 8,7 ohm es 8,7 +- 1,1. Con resistencias patron al 1 % ese error baja a
 * ~1 % y ademas queda medido en vez de estimado.
 *
 * PENDIENTE, Y YA ES LA TERCERA VEZ: calibrar con resistencias patron de
 * 1 % (47, 100, 220, 470 ohm) y ajustar Z = a*Vadc + b por cuadrados
 * minimos. Eso cierra de una sola vez la ganancia real, la corriente real y
 * el deficit del detector, y da el residuo, que es la cifra de exactitud del
 * instrumento. Mientras la calibracion se derive de la cadena de ganancias,
 * cada retoque de hardware obliga a rehacer todo esto.
 *
 * Detalle completo: claude/chidori-cadena-de-ganancia.md
 */

/* ================= PLACA · ELEGIR ANTES DE FLASHEAR =================
 *
 * No todas las placas tienen la misma ganancia. El 27/09/2026 se cambio R9
 * (entrada de U4D, con R10 = 10k) de 2,2k a 1,1k en una placa: U4D pasa de
 * x4,5 a x9,1 y la cadena entera gana el doble. Con el firmware equivocado
 * la Z sale al doble (o a la mitad) SIN NINGUN AVISO: asi quedo la sesion 9
 * de P-004, medida con R9 = 1,1k y este firmware todavia en 2,2k.
 *
 *   R9_OHM 2200 -> rev 3: la calibracion MEDIDA en banco el 15/09 (arriba).
 *   R9_OHM 1100 -> rev 4: DERIVADA de rev 3, K_CAL x 2. No medida en banco.
 *
 * Para saber cual tiene una placa: mirar R9, al lado de U4 (pin 13). Si hay
 * duda, osciloscopio en U4 pin 8 y pin 14: la relacion da ~4,5 con 2,2k y
 * ~9 con 1,1k.
 *
 * Supuestos de la rev 4: (a) el resto de la placa es igual a rev 3
 * (corriente, INA, filtros); (b) el deficit del detector sigue en 0,169 V
 * con el doble de amplitud. El GBW del TL084 le resta ~1 % a U4D con 1,1k
 * (factor real 1,98-1,99, no 2): queda dentro del 13 % de rev 3.
 *
 * El rango se achica a la mitad con 1,1k:
 *   R9 2,2k : 2,03 ohm (Vadc = 0) a ~26 ohm
 *   R9 1,1k : 1,01 ohm (Vadc = 0) a ~13 ohm   <- pegado a ~13 es RECORTE
 *
 * El equipo reporta su K_CAL en cada STATUS y la base etiqueta sola cada
 * sesion con la calibracion que corresponde (tabla `calibrations`, 3 y 4).
 */
#define R9_OHM              1100      // <-- 2200 o 1100, SEGUN LA PLACA

#define V_DETECTOR          0.169f    // deficit del detector de envolvente [V]
#if   R9_OHM == 2200
  #define K_CAL             0.16675f  // rev 3 · I_pp x G, medida 2026-09-15
  #define CAL_TAG           "rev3 · R9 2,2k · banco 2026-09-15"
#elif R9_OHM == 1100
  #define K_CAL             0.33350f  // rev 4 · rev 3 x (2,2k / 1,1k)
  #define CAL_TAG           "rev4 · R9 1,1k · rev3 x2, derivada"
#else
  #error "R9_OHM tiene que ser 2200 o 1100: no hay calibracion para otro valor"
#endif

#define VREF                3.3
#define RESOLUCION          4095
#define ADC(x)              ((x) * VREF / (RESOLUCION))
#define Amp2Vpp(x)          ((x) * 2.0)

/* ================= MUESTREO ================= */
#define FREQ                50000.0   // frecuencia de inyección AD9833
#define SAMPLE_INTERVAL_US  1428      // ~700 Hz
#define AVG_SAMPLES         192       // 192 @ 700 Hz ≈ 274 ms por Z cruda
#define TX_INTERVAL_MS      250       // ~4 Hz hacia el frontend

/* Cadena de filtrado sobre Z · MEDIANA y despues MEDIA.
 *
 * La media sola NO rechaza impulsos: un unico spike de +5 ohm se reparte y
 * contamina las CANT_MUESTRAS salidas siguientes con +0.5 ohm. Sobre un rango
 * util de ~4.6 ohm (la caida de 1.5 dB) eso es un 11 % de error arrastrado.
 * La mediana lo descarta entero, y recien despues se promedia para bajar el
 * ruido gaussiano. El orden importa: promediar primero ya habria mezclado el
 * spike con sus vecinos.
 *
 * Costo: MEDIANA_N * AVG_SAMPLES / 700 Hz de latencia extra (~1.4 s). El
 * llenado vesical es de escala de minutos, asi que sobra. */
#define MEDIANA_N           5         // ventana de la mediana (impar)
#define CANT_MUESTRAS       12        // media movil posterior
#define WARMUP_MUESTRAS     5         // no transmitir hasta estabilizar
// Si el scheduler se atrasa más de esto, re-sincroniza (evita ráfagas)
#define MAX_LAG_INTERVALS   4

/* ================= AD9833 ================= */
constexpr uint16_t CMD_RESET           = 0x2100;
constexpr uint16_t CMD_EXIT_RESET_SINE = 0x2000;
constexpr uint16_t REG_FREQ0           = 0x4000;
constexpr uint16_t REG_PHASE0          = 0xC000;
constexpr double   MCLK                = 25e6;

/* ================= WiFi / ACCESS POINT ================= */
const char*    MDNS_HOSTNAME          = "chidori";

// ── MODO AP (Access Point) ───────────────────────────────────────────
// El ESP crea su PROPIA red WiFi; la Mac se conecta directo. Sin router,
// sin hotspot, sin portal, sin credenciales, sin IP que dependa de la red.
const char*    AP_SSID                = "Chidori";        // red que crea el ESP
const char*    AP_PASSWORD            = "chidori123";     // WPA2, min 8 chars

// Canal WiFi del AP. 1 = comportamiento de siempre (default del core).
// Si hay interferencia (muchos routers vecinos en canal 1), probar 6 u 11:
// cambia SOLO la frecuencia de radio, nada del protocolo ni de la app.
const uint8_t  AP_CHANNEL             = 1;

// Heartbeat WS: ping cada 15 s, espera pong 3 s, 2 fallos = desconectar.
// ESTO es lo que elimina los clientes fantasma de los page-refresh.
const uint32_t WS_PING_INTERVAL_MS    = 15000;
const uint32_t WS_PONG_TIMEOUT_MS     = 3000;
const uint8_t  WS_PONG_RETRIES        = 2;

WebSocketsServer webSocket(81);

/* ================= VARIABLES GLOBALES ================= */
float muestras[CANT_MUESTRAS];
int   size_m    = 0;
float average_Z = 0;

/* Ventana de la mediana · previa a la media movil */
float med_buf[MEDIANA_N];
int   med_n = 0;

// Ultima tension pico-pico del detector (la que alimenta el calculo de Z).
// Se transmite junto con Z como dato de referencia/diagnostico. Es solo una
// asignacion por ciclo: no altera el muestreo ni el calculo.
float last_Vpp  = 0.0f;
/* Continua LEIDA en A0 (promedio calibrado de AVG_SAMPLES lecturas), en volts.
 * Es el dato tal como entra: sin el x2 ni la compensacion del Schottky. Se
 * transmite aparte para poder contrastarlo con el tester en el propio pin —
 * la Vpp reconstruida no es medible en ningun nodo del circuito. */
float last_Vadc = 0.0f;

/* Numero de secuencia de las Z producidas · SE INCREMENTA SIEMPRE que se
 * calcula una Z valida (pasado el warmup), se transmita o no.
 *
 * Es lo que permite al frontend contar las muestras REALMENTE perdidas: si
 * entre dos mensajes recibidos la secuencia salta de 1500 a 1512, se perdieron
 * 11 muestras, sin importar cuanto tardaron en llegar. Antes se estimaba el
 * hueco multiplicando su duracion por una frecuencia supuesta de 4 Hz, lo que
 * contaba como perdido todo lo que en realidad solo venia demorado.
 *
 * NO se reinicia en cada START: es monotono desde el arranque del equipo, asi
 * que reanudar una medicion pausada no lo hace saltar para atras. */
uint32_t z_seq = 0;

unsigned long t_debounce     = 0;
unsigned long last_sample_us = 0;
unsigned long last_tx_ms     = 0;
unsigned long last_status_ms = 0;

uint32_t adc_sum   = 0;
uint16_t adc_count = 0;

bool botonConfirmado = false;
int  debounceCount   = 0;
const int DEBOUNCE_START_CUENTAS = 8;    // 80 ms para ARRANCAR
const int DEBOUNCE_STOP_CUENTAS  = 150;  // 1.5 s de hold para PARAR (anti-corte espurio en mediciones largas)

bool First_Measure = true;

/* ================= MÁQUINA DE ESTADOS =================
 * La alarma se evalúa ÚNICAMENTE en el frontend. El firmware es un
 * sensor "dumb": mide y transmite. ALARMA queda por compatibilidad. */
typedef enum { INACTIVO, MIDIENDO, ALARMA } state_t;

typedef struct {
  state_t estado;
  float   Z;
  float   Ref;
} sensor_t;

sensor_t Chidori;

/* ================= PROTOTIPOS ================= */
void Inicializar_AD9833();
void ad9833Write(uint16_t data);
void ad9833SetFrequency(double freqHz);
void ad9833Begin(double freqHz);
void Inicializar_AP();
void onWiFiEvent(WiFiEvent_t event);
int8_t apStationRSSI();
const char* resetReasonName(esp_reset_reason_t r);
void startNetworkServices();
void webSocketEvent(uint8_t num, WStype_t type, uint8_t * payload, size_t length);
void adquirir_y_promediar();
float Calcular_mediana(float Z);
void Calcular_promedio(float Z);
void checkButton();
void resetMedicion();
void startMeasurement(const char* origen);
void stopMeasurement(const char* origen);
void statusTick();

/* ================= SETUP ================= */
void setup() {
  Serial.begin(115200);
  delay(3000);
  Serial.println("\n=== ESP32-C3 CHIDORI · ACCESS POINT ===");

  // ★ DIAGNÓSTICO: por qué arrancó el chip. Si durante una medición larga
  // el serial muestra un boot nuevo con "BROWNOUT", la causa de la
  // desconexión es ALIMENTACIÓN (batería/cable), no WiFi.
  Serial.print("Motivo del reset: ");
  Serial.println(resetReasonName(esp_reset_reason()));

  pinMode(BUZZER, OUTPUT);
  pinMode(BUTTON, INPUT);            // pull-down externo 2.2k en PCB
  digitalWrite(BUZZER, LOW);

  // Calibracion en uso (ver el bloque CALIBRACION arriba)
  Serial.print("K_CAL = ");             Serial.print(K_CAL, 5);
  Serial.print(" A  ·  V_DETECTOR = "); Serial.print(V_DETECTOR, 3); Serial.println(" V");
  Serial.print("Placa: R9 = ");         Serial.print(R9_OHM);    Serial.println(" ohm");
  Serial.print("Z = 2*(Vadc + V_DETECTOR) / K_CAL   ["); Serial.print(CAL_TAG); Serial.println("]");

  Chidori.estado = INACTIVO;
  Chidori.Z      = 0.0f;
  Chidori.Ref    = 0.0f;

  // ADC: atenuación 11 dB explícita (rango completo 0–3.3 V aprox.)
  analogSetPinAttenuation(ADC_PIN, ADC_11db);

  // ★ AD9833 PRIMERO, con el WiFi todavía apagado.
  // Reproduce el entorno del sketch "soloAD" (alimentación sin los picos
  // de corriente de la radio) → init SPI confiable siempre.
  Inicializar_AD9833();

  // Levantar el Access Point (red propia del ESP)
  Inicializar_AP();
}

/* ================= LOOP PRINCIPAL ================= */
void loop() {
  webSocket.loop();
  statusTick();

  // Antirrebote del botón cada 10 ms
  if (millis() - t_debounce >= 10) {
    t_debounce = millis();
    checkButton();
  }

  // Muestreo ADC a ~700 Hz solo midiendo
  if (Chidori.estado == MIDIENDO) {
    unsigned long now_us = micros();
    if (now_us - last_sample_us >= SAMPLE_INTERVAL_US) {
      // Si nos atrasamos mucho (reconexión WiFi, etc.) re-sincronizamos
      // en vez de disparar una ráfaga de muestras para "ponernos al día".
      if (now_us - last_sample_us > (unsigned long)SAMPLE_INTERVAL_US * MAX_LAG_INTERVALS) {
        last_sample_us = now_us;
      } else {
        last_sample_us += SAMPLE_INTERVAL_US;
      }
      adquirir_y_promediar();
    }
  }

  switch (Chidori.estado) {
    case INACTIVO:
      if (botonConfirmado) {
        botonConfirmado = false;
        startMeasurement("boton");
      }
      break;

    case MIDIENDO:
      if (botonConfirmado) {
        botonConfirmado = false;
        stopMeasurement("boton");
      }
      break;

    case ALARMA:   // compatibilidad · hoy no se entra automáticamente
      if (botonConfirmado) {
        botonConfirmado = false;
        stopMeasurement("boton");
      }
      break;
  }
}

/* ─────────────────────────────────────────────────────────────────────
 *  START / STOP centralizados
 *  START re-inicializa el AD9833: si por cualquier glitch dejó de
 *  generar, cada medición arranca con la senoidal garantizada.
 *  Costo: 6 escrituras SPI (~µs), imperceptible.
 * ───────────────────────────────────────────────────────────────────── */
void startMeasurement(const char* origen) {
  ad9833Begin(FREQ);                  // ★ re-init defensivo del generador
  resetMedicion();
  Chidori.estado = MIDIENDO;
  last_sample_us = micros();
  Serial.print(">> MIDIENDO (por "); Serial.print(origen); Serial.println(")");
}

void stopMeasurement(const char* origen) {
  Chidori.estado = INACTIVO;
  digitalWrite(BUZZER, LOW);
  First_Measure  = true;
  // Confirmacion audible del hold de 1.5 s: el usuario mantiene apretado
  // hasta el beep y recien ahi suelta. (No suena en STOP por la app.)
  if (strncmp(origen, "boton", 5) == 0) {
    digitalWrite(BUZZER, HIGH); delay(60); digitalWrite(BUZZER, LOW);
  }
  Serial.print(">> INACTIVO (por "); Serial.print(origen); Serial.println(")");
}

/* ─────────────────────────────────────────────────────────────────────
 *  WiFi: modo Access Point (el ESP crea su propia red "Chidori")
 * ───────────────────────────────────────────────────────────────────── */
void Inicializar_AP() {
  // ── MODO ACCESS POINT ──────────────────────────────────────────────
  // El ESP crea su PROPIA red WiFi. La Mac se conecta directo a 'Chidori'
  // y abre la UI apuntando a 192.168.4.1:81. No depende de ningun router,
  // hotspot ni credenciales: funciona igual en cualquier lugar.
  // ★ DIAGNÓSTICO: log con timestamp cada vez que una estación (la Mac)
  // se asocia o se cae del AP. Registrado ANTES de levantar el AP para
  // no perder el evento AP_START.
  WiFi.onEvent(onWiFiEvent);

  WiFi.mode(WIFI_AP);

  // IP fija del AP: SIEMPRE 192.168.4.1 (lo que va en la UI).
  WiFi.softAPConfig(IPAddress(192, 168, 4, 1),
                    IPAddress(192, 168, 4, 1),
                    IPAddress(255, 255, 255, 0));

  bool ok = WiFi.softAP(AP_SSID, AP_PASSWORD, AP_CHANNEL);

  if (!ok) {
    Serial.println("No se pudo iniciar el Access Point. Reiniciando...");
    delay(2000);
    ESP.restart();
  }

  // Power save OFF: con el modem dormido entre beacons, los paquetes salen en
  // rafagas y el frontend ve huecos de cientos de ms. Es la causa clasica de
  // los microcortes de este tipo. En AP consume mas, pero el equipo mide
  // enchufado a bateria durante sesiones de horas: la continuidad importa mas.
  WiFi.setSleep(false);

  // TX power 8.5 dBm: fix de antena del C3 Super Mini + evita brown-out USB.
  WiFi.setTxPower(WIFI_POWER_8_5dBm);

  Serial.println("Access Point activo");
  Serial.print("   Red WiFi: ");  Serial.println(AP_SSID);
  Serial.print("   Clave:    ");  Serial.println(AP_PASSWORD);
  Serial.print("   Canal:    ");  Serial.println(AP_CHANNEL);
  Serial.print("   IP:       ");  Serial.println(WiFi.softAPIP());
  Serial.println("   En la Mac: conectate a la red 'Chidori' y abri la UI con IP 192.168.4.1 puerto 81");

  startNetworkServices();
}

/* mDNS + WebSocket server. Se llama al boot y tras cada reconexión. */
void startNetworkServices() {
  MDNS.end();
  if (MDNS.begin(MDNS_HOSTNAME)) {
    MDNS.addService("ws", "tcp", 81);
    Serial.print("✅ mDNS → ws://"); Serial.print(MDNS_HOSTNAME); Serial.println(".local:81");
    Serial.print("   (si .local falla, usar la IP directa: ");
    Serial.print(WiFi.softAPIP()); Serial.println(":81)");
  } else {
    Serial.println("⚠ mDNS no inició · usar la IP directa");
  }

  static bool wsStarted = false;
  if (!wsStarted) {
    webSocket.begin();
    webSocket.onEvent(webSocketEvent);
    // ★ Heartbeat: elimina clientes fantasma (refresh del navegador,
    // celular que se fue de rango). Sin esto broadcastTXT se degrada.
    webSocket.enableHeartbeat(WS_PING_INTERVAL_MS, WS_PONG_TIMEOUT_MS, WS_PONG_RETRIES);
    wsStarted = true;
  }
}

/* Eventos del driver WiFi · SOLO LOG DIAGNÓSTICO (modo AP).
 * En AP no hay reconexión que manejar: el ESP no hace nada, solo deja
 * constancia con timestamp de cuándo la Mac se asocia o se cae, para
 * poder correlacionar las desconexiones de las mediciones largas.
 * (Mismo patrón que el ejemplo oficial WiFiClientEvents del core.) */
void onWiFiEvent(WiFiEvent_t event) {
  switch (event) {
    case ARDUINO_EVENT_WIFI_AP_STACONNECTED:
      Serial.print("[wifi ");   Serial.print(millis() / 1000);
      Serial.println(" s] estación ASOCIADA al AP (la Mac entró a la red)");
      break;
    case ARDUINO_EVENT_WIFI_AP_STADISCONNECTED:
      Serial.print("[wifi ");   Serial.print(millis() / 1000);
      Serial.println(" s] ⚠ estación DESASOCIADA del AP (la Mac se fue de la red)");
      break;
    case ARDUINO_EVENT_WIFI_AP_START:
      Serial.print("[wifi ");   Serial.print(millis() / 1000);
      Serial.println(" s] AP iniciado");
      break;
    case ARDUINO_EVENT_WIFI_AP_STOP:
      Serial.print("[wifi ");   Serial.print(millis() / 1000);
      Serial.println(" s] ⚠⚠ AP DETENIDO (esto NO debería pasar nunca)");
      break;
    default:
      break;
  }
}

/* RSSI real del enlace: señal con la que el AP escucha a la primera
 * estación conectada (la Mac). 0 = sin estaciones. Valores típicos:
 * -30 excelente · -60 buena · -75 al límite · -85 casi inutilizable. */
int8_t apStationRSSI() {
  wifi_sta_list_t stations;
  if (esp_wifi_ap_get_sta_list(&stations) != ESP_OK) return 0;
  if (stations.num < 1) return 0;
  return stations.sta[0].rssi;
}

/* Nombre legible del motivo del último reset (diagnóstico de cortes) */
const char* resetReasonName(esp_reset_reason_t r) {
  switch (r) {
    case ESP_RST_POWERON:  return "POWERON (encendido normal)";
    case ESP_RST_SW:       return "SW (reinicio por software)";
    case ESP_RST_BROWNOUT: return "BROWNOUT ⚠ (caída de alimentación: revisar batería/cable USB)";
    case ESP_RST_PANIC:    return "PANIC ⚠ (crash del firmware)";
    case ESP_RST_INT_WDT:  return "INT_WDT ⚠ (watchdog de interrupciones)";
    case ESP_RST_TASK_WDT: return "TASK_WDT ⚠ (watchdog de tareas)";
    case ESP_RST_WDT:      return "WDT ⚠ (otro watchdog)";
    case ESP_RST_DEEPSLEEP:return "DEEPSLEEP";
    case ESP_RST_EXT:      return "EXT (pin de reset)";
    default:               return "DESCONOCIDO";
  }
}

/* Línea de diagnóstico cada 10 s */
void statusTick() {
  if (millis() - last_status_ms < 10000) return;
  last_status_ms = millis();

  Serial.print("[status] estado=");
  Serial.print(Chidori.estado == MIDIENDO ? "MIDIENDO" : "INACTIVO");
  Serial.print(" · up="); Serial.print(millis() / 1000); Serial.print("s");
  Serial.print(" · modo=AP ip="); Serial.print(WiFi.softAPIP());
  Serial.print(" · stations="); Serial.print(WiFi.softAPgetStationNum());
  Serial.print(" · rssi="); Serial.print(apStationRSSI());
  Serial.print(" · clientesWS="); Serial.print(webSocket.connectedClients());
  Serial.print(" · heap="); Serial.print(ESP.getFreeHeap());
  Serial.print(" · Z="); Serial.println(Chidori.Z, 3);
}

/* ================= AD9833 ================= */
void Inicializar_AD9833() {
  pinMode(PIN_FSYNC, OUTPUT);
  digitalWrite(PIN_FSYNC, HIGH);
  SPI.begin(PIN_SCK, -1, PIN_MOSI, -1);   // CS manual, sin MISO
  SPI.beginTransaction(SPISettings(1000000, MSBFIRST, SPI_MODE2));
  delay(100);                              // settle (igual que sketch soloAD)
  ad9833Begin(FREQ);
  Serial.println("✅ AD9833 inicializado a 50 kHz (seno) · antes del WiFi");
}

/* Palabra de 16 bits en dos transfers de 8 → MSB-first garantizado
 * independiente del endianness (C3 es RISC-V little-endian). */
void ad9833Write(uint16_t data) {
  digitalWrite(PIN_FSYNC, LOW);
  delayMicroseconds(1);                  // tCSS
  SPI.transfer((uint8_t)(data >> 8));
  SPI.transfer((uint8_t)(data & 0xFF));
  digitalWrite(PIN_FSYNC, HIGH);
  delayMicroseconds(2);                  // tCSH
}

/* Solo escribe FREQ0 (LSB+MSB). No toca el control register. */
void ad9833SetFrequency(double freqHz) {
  uint32_t freqWord = (uint32_t)((freqHz * (1UL << 28)) / MCLK);
  ad9833Write(REG_FREQ0 | (uint16_t)(freqWord        & 0x3FFF));
  ad9833Write(REG_FREQ0 | (uint16_t)((freqWord >> 14) & 0x3FFF));
}

/* Secuencia oficial (datasheet AD9833 / AN-1070):
 *   RESET=1 → FREQ0 LSB → FREQ0 MSB → PHASE0 → RESET=0 (seno) */
void ad9833Begin(double freqHz) {
  ad9833Write(CMD_RESET);
  delayMicroseconds(5);
  ad9833SetFrequency(freqHz);
  ad9833Write(REG_PHASE0 | 0x0000);
  delayMicroseconds(5);
  ad9833Write(CMD_EXIT_RESET_SINE);
}

/* ================= WEBSOCKET ================= */
/* El frontend hace parseFloat(msg) e ignora lo no-numérico (NaN),
 * así que las respuestas de texto (STATUS/PONG) no lo rompen. */
void webSocketEvent(uint8_t num, WStype_t type, uint8_t * payload, size_t length) {
  switch (type) {
    case WStype_CONNECTED: {
      IPAddress ip = webSocket.remoteIP(num);
      Serial.print("WS cliente #"); Serial.print(num);
      Serial.print(" conectado desde "); Serial.println(ip);
      return;
    }
    case WStype_DISCONNECTED:
      Serial.print("WS cliente #"); Serial.print(num); Serial.println(" desconectado");
      return;
    case WStype_TEXT:
      break;
    default:
      return;
  }

  const char* cmd = (const char*)payload;   // la lib null-termina los TEXT
  Serial.print("Comando WS: "); Serial.println(cmd);

  if (strcmp(cmd, "START") == 0 && Chidori.estado == INACTIVO) {
    startMeasurement("WS");
  }
  else if (strcmp(cmd, "STOP") == 0) {
    stopMeasurement("WS STOP");
  }
  else if (strcmp(cmd, "RESET") == 0) {
    stopMeasurement("WS RESET");
    resetMedicion();
  }
  else if (strcmp(cmd, "PING") == 0) {
    webSocket.sendTXT(num, "PONG");
  }
  else if (strcmp(cmd, "STATUS") == 0) {
    /* kcal y vdet viajan para que la app NO tenga que suponer con que
     * constantes midio el equipo. Antes la sesion se etiquetaba con el
     * default de la base: si se flasheaba un firmware viejo por error, el
     * dato quedaba guardado con la escala equivocada y nadie se enteraba.
     * Ahora la app compara el kcal recibido contra la tabla `calibrations`
     * y etiqueta la sesion por lo que REALMENTE la midio. */
    char buf[176];
    snprintf(buf, sizeof(buf),
             "STATUS estado=%s rssi=%d heap=%u Z=%.3f v=%.4f kcal=%.5f vdet=%.3f",
             Chidori.estado == MIDIENDO ? "MIDIENDO" : "INACTIVO",
             (int)apStationRSSI(),   // antes: WiFi.RSSI(), que en modo AP es basura
             (unsigned)ESP.getFreeHeap(), Chidori.Z, last_Vpp,
             (double)K_CAL, (double)V_DETECTOR);
    webSocket.sendTXT(num, buf);
  }
}

/* ================= ADQUISICIÓN ================= */
void adquirir_y_promediar() {
  // analogReadMilliVolts aplica la curva de calibracion de fabrica (eFuse).
  // analogRead() * 3.3 / 4095 asumia un ADC lineal, y el del ESP32-C3 no lo es:
  // el error dependia del punto de trabajo y se propagaba a Vpp y a Z.
  adc_sum += analogReadMilliVolts(ADC_PIN);
  adc_count++;

  if (adc_count < AVG_SAMPLES) return;

  float avg_mv = (float)adc_sum / AVG_SAMPLES;   // ya en milivolts calibrados
  adc_sum   = 0;
  adc_count = 0;

  float voltage = avg_mv / 1000.0f;
  last_Vadc     = voltage;                 // crudo de A0, sin reconstruir
  float Vpp     = Amp2Vpp(voltage + V_DETECTOR);
  float Z       = Vpp / K_CAL;
  last_Vpp      = Vpp;                     // para el TX (dato de referencia)

  // MEDIANA primero (mata impulsos), MEDIA despues (baja ruido gaussiano)
  Z = Calcular_mediana(Z);
  Calcular_promedio(Z);
  Chidori.Z = average_Z;

  // ── WARMUP: no transmitir ni calibrar Z_ref con transitorios ──
  if (size_m < WARMUP_MUESTRAS) {
    Serial.print("[warmup] "); Serial.print(size_m);
    Serial.print("/"); Serial.print(WARMUP_MUESTRAS);
    Serial.print(" · Z parcial = "); Serial.println(Chidori.Z, 3);
    return;
  }

  if (First_Measure) {
    Chidori.Ref   = Chidori.Z;
    First_Measure = false;
    Serial.print("⭐ Z_ref calibrada: "); Serial.print(Chidori.Ref, 3); Serial.println(" Ω");
  }

  // Una Z valida mas. Se cuenta ACA, antes del gate de transmision, para que
  // la secuencia refleje lo MEDIDO y no lo enviado: asi el frontend distingue
  // "dato que llego tarde" de "dato que nunca llego".
  z_seq++;

  // ── TX cada TX_INTERVAL_MS · sin String (cero fragmentación) ──
  if (millis() - last_tx_ms >= TX_INTERVAL_MS) {
    last_tx_ms = millis();
    // Formato: "<Z> <Vpp> <Vadc> <t_ms> <seq>"
    //   (ej: "22.30942 1.5234 0.5617 184532 671")
    //   Z    · impedancia calculada
    //   Vpp  · pico a pico reconstruido en la salida del receptor (deriva de Vadc)
    //   Vadc · CONTINUA MEDIDA EN A0, en volts · contrastable con el tester
    //   t_ms · millis() del ESP · RELOJ DEL EQUIPO, no del navegador
    //   seq  · numero de Z producidas desde el arranque (ver z_seq)
    //
    // POR QUE t_ms · hasta ahora el frontend le ponia a cada muestra la hora en
    // que LLEGABA. Con el WiFi tartamudeando (medido: cortes de 1-2 s cada ~6 s
    // por el escaneo de redes de la laptop), los datos se acumulan y llegan en
    // rafaga, y la curva quedaba dibujada con huecos y apelotonamientos que no
    // existieron en la medicion. Con el reloj del ESP cada muestra queda en el
    // instante en que de verdad se midio, y el eje de tiempo pasa a ser exacto.
    //
    // t_ms es desde el ARRANQUE del equipo (no desde el START): es monotono, no
    // se reinicia al reanudar una medicion pausada, y el frontend arma el tiempo
    // de sesion restando el t_ms de la primera muestra.
    char msg[64];
    snprintf(msg, sizeof(msg), "%.5f %.4f %.4f %lu %lu",
             Chidori.Z, last_Vpp, last_Vadc,
             (unsigned long)millis(), (unsigned long)z_seq);
    if (webSocket.connectedClients() > 0) {   // en AP el radio está siempre up
      webSocket.broadcastTXT(msg);
    }
    Serial.print("Z = "); Serial.println(msg);
  }
}

/* Mediana movil de MEDIANA_N · rechazo de impulsos.
 *
 * Mientras la ventana no esta llena devuelve el valor tal cual: al arrancar es
 * preferible responder que filtrar, y el WARMUP ya descarta esos primeros
 * valores. Ordena una copia (N es chico, la insercion directa es mas barata
 * que cualquier algoritmo "listo"). */
float Calcular_mediana(float Z) {
  if (med_n < MEDIANA_N) {
    med_buf[med_n++] = Z;
    if (med_n < MEDIANA_N) return Z;
  } else {
    for (int i = 0; i < MEDIANA_N - 1; i++) med_buf[i] = med_buf[i + 1];
    med_buf[MEDIANA_N - 1] = Z;
  }

  float tmp[MEDIANA_N];
  for (int i = 0; i < MEDIANA_N; i++) tmp[i] = med_buf[i];
  for (int i = 1; i < MEDIANA_N; i++) {
    float v = tmp[i];
    int j = i - 1;
    while (j >= 0 && tmp[j] > v) { tmp[j + 1] = tmp[j]; j--; }
    tmp[j + 1] = v;
  }
  return tmp[MEDIANA_N / 2];
}

void Calcular_promedio(float Z) {
  if (size_m < CANT_MUESTRAS) {
    muestras[size_m++] = Z;
  } else {
    for (int i = 0; i < CANT_MUESTRAS - 1; i++)
      muestras[i] = muestras[i + 1];
    muestras[CANT_MUESTRAS - 1] = Z;
  }
  average_Z = 0;
  for (int i = 0; i < size_m; i++)
    average_Z += muestras[i];
  average_Z /= size_m;
}

/* ================= BOTÓN (antirrebote) ================= */
void checkButton() {
  // Umbral asimetrico anti-corte: ARRANCAR es rapido (80 ms), pero PARAR
  // una medicion en curso exige un hold deliberado de 1.5 s. Asi un roce,
  // vibracion o glitch electrico NO puede frenar una sesion de horas.
  const int umbral = (Chidori.estado == INACTIVO) ? DEBOUNCE_START_CUENTAS
                                                  : DEBOUNCE_STOP_CUENTAS;
  if (digitalRead(BUTTON) == HIGH) {
    if (debounceCount < umbral) {
      debounceCount++;
      if (debounceCount >= umbral) {
        botonConfirmado = true;
      }
    }
  } else {
    debounceCount = 0;
  }
}

/* ================= UTILIDADES ================= */
void resetMedicion() {
  size_m        = 0;
  average_Z     = 0;
  med_n         = 0;     // sin esto, la sesion nueva arranca con Z de la anterior
  adc_sum       = 0;
  adc_count     = 0;
  First_Measure = true;
  last_tx_ms    = millis();
}
