lpires211002/CHIDORI_Proyecto_final_de_carrera/(commit log)

2025-11-28 corrijo descarga de .txt
2025-11-30 Agrego huellas y symbols de AD9833
    [INA122U.step, PCB PFC.kicad_pcb, PCB PFC.kicad_sch]
2025-12-10 Cambio valores a comerciales y agrego OpAmps SMD
    [PCB PFC.kicad_pcb, PCB PFC.kicad_sch]
2025-12-18 Placa final chidori 3V3 by Gus
    [PCB PFC.kicad_pcb, PCB PFC.kicad_sch]
2025-12-18 Pruebas pfc con arduino
2026-03-24 Cambios en el filtrado
2026-04-01 pruebo capacitores schottky
2026-05-22 Cambio del filtrado actual, más ganancia y cambio de capa
2026-05-22 cambio de capa
2026-05-24 actualizacion de placa y filtrado: correccion de ad9833 e ina + filtrado
    [PCB PFC.kicad_pcb, PCB PFC.kicad_sch]
2026-05-24 no se que onda
2026-05-24 feat: vejiga dinámica, asistente de calibración e integración con Supabase Cloud
2026-05-25 feat: favicon PNG + firmware ESP32-C3 alineado con esquemático
    Frontend:
    - Reemplazo favicon vite.svg por favicon.png (movido a public/)
    - Agrego apple-touch-icon
    Firmware ESP32-C3 Optimizado:
    - Corrijo pines según esquemático KiCAD:
    - ADC_PIN: GPIO3 → GPIO0 (Vout del detector Schottky)
    - BUZZER: GPIO21 → GPIO5 (alarm)
    - BUTTON, SPI: ya estaban bien (GPIO20, 4, 6, 7)
    - Restauro factor x2 (Amp2Vpp) en el cálculo de Z: el ADC mide pico
    por el rectificador Schottky BAT54S, no Vpp
    - Cadencia de envío configurable vía TX_INTERVAL_MS (default 1 s),
    manteniendo muestreo interno a 700 Hz + promedio de 256
    - SPI con CS manual: SPI.begin(SCK, -1, MOSI, -1)
    - Función resetMedicio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
    [Chidori_ESP32C3_Optimizado.ino]
2026-05-25 feat(ui): rediseño editorial clínico · elimina AI slop, hardening de seguridad
    Rediseño completo del frontend siguiendo la skill /impeccable, en respuesta a
    una crítica que detectó: 20/40 en Nielsen, 7 anti-patterns deterministas,
    y veredicto YES de AI slop. Tono pedido: editorial / científico / premium clinical.
    Sistema de diseño (DESIGN.md):
    - Paleta OKLCH 3-color: 1 signal indigo + 1 alarm rust + neutrales tintados warm
    - Sin #000 / #fff puros; sombras tintadas con oklch alpha
    - Fraunces (display serif) + IBM Plex Sans + IBM Plex Mono (tabular nums)
    - Geometría square-shouldered (radios 4/6/10px)
    - Motion: ease-out-quart, sin bounce, sin layout transitions, sin ripples
    Segurida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
2026-05-25 fix(alarm): edge-triggered + audio context teardown
    Bug: tras reconocer la alarma volvía a sonar inmediatamente con cada
    nueva muestra que llegaba debajo del umbral (lógica level-triggered).
    Fix:
    - Nueva flag `alarmArmed` (default true). La alarma solo dispara cuando
    está armada Y la lectura cruza el umbral hacia abajo.
    - Reconocer pone `alarmFired = false` pero mantiene `alarmArmed = false`.
    - La alarma se re-arma sola cuando Z sube por encima del umbral más una
    histéresis (2% del umbral o 0.5 Ω, lo que sea mayor) para evitar
    chatter en el borde.
    - Reset y SaveCalibration re-arman explícitamente.
    Hardening adicional en AlarmBanner:
    - teardown() centralizado cierra el AudioCon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
2026-05-25 feat(auth): Supabase Auth hardcodeado + roles + admin view
    Cambios estructurales:
    - Supabase URL/anon key hardcodeadas vía .env.local (gitignored) + .env.example
    - supabaseClient ahora es singleton importable, no se configura desde la UI
    - Removido bloque "Persistencia en la nube" del SettingsPanel (queda solo info)
    Auth flow:
    - useAuth hook con estados loading/anon/pending-approval/ready
    - LoginScreen acepta usuario simple ("sa") o email completo
    · "sa" se mapea a sa@chidori.local, "juan" a juan@chidori.local
    · self-signup permitido pero requiere aprobación del admin
    - PendingApproval con auto-refresh cada 20s
    - AuthSplash mientras se resuelve la sesión inicial
    Vista admin (rol '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
2026-05-25 fix(admin): join sessions↔profiles en cliente
    PostgREST no infiere la relación entre sessions y profiles porque la FK
    de sessions.user_id apunta a auth.users (no directamente a profiles).
    Esto causaba el error "Could not find a relationship between sessions
    and profiles in the schema cache" al cargar el AdminView.
    Solución: en loadSessions hacemos dos queries (sessions + profiles by
    user_id IN) y unimos en cliente. Más resiliente, no requiere cambios
    de schema, y como el AdminView no es performance-crítico, no hay
    penalización notable.
2026-05-25 feat(admin): toggle Dashboard ↔ AdminView para el superadmin
    El admin ahora puede tomar mediciones como cualquier clínico, además
    de gestionar usuarios y ver el catálogo global de sesiones.
    Implementación:
    - App.jsx mantiene un estado `adminMode` ('panel' | 'dashboard')
    persistido en localStorage. Default a 'panel' la primera vez.
    - AdminView agrega un botón "Tomar mediciones" en el header (icono
    Activity) que cambia a modo dashboard.
    - Dashboard acepta props isAdmin + onSwitchToAdmin. Cuando se renderiza
    para un admin, muestra:
    · brand-tag cambiado a "Modo medición · sesión administrativa"
    · botón "Panel admin" en el header (icono Shield) para volver
    - Las sesiones q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
2026-05-25 feat(export): toggle "Guardar en la base de datos" en ExportModal
    Agrega un switch al modal de exportar (true por defecto) que controla
    si los exports también persisten los datos del paciente en Supabase.
    - ON (default): comportamiento previo · cada export hace UPDATE de la
    sesión con la info del formulario + final_impedance + total_events
    - OFF: el archivo PDF/CSV/TXT se descarga normalmente, pero NO se toca
    Supabase. La sesión queda en la nube como "Sesión sin identificar".
    El botón "Guardar paciente" queda deshabilitado cuando el switch está
    en OFF (con tooltip explicativo).
2026-05-25 feat(admin): editar, eliminar y descargar sesiones desde AdminView
    Nuevo módulo `src/lib/exporters.js` con funciones puras (exportPDF /
    exportCSV / exportTXT) que aceptan datos crudos sin asumir DOM ni Chart.
    Compartido entre ExportModal del Dashboard y SessionDetailModal del
    AdminView, eliminando duplicación.
    SessionDetailModal ahora soporta:
    - Modo "view": stats + datos del paciente + tabla de mediciones + eventos
    - Modo "edit": formulario completo con todos los campos editables
    (paciente, sexo, peso, altura, circ. suprailíaca, menstruación, Z basal,
    Z final, duración, total de eventos) + UPDATE en Supabase al guardar
    - Botón "Eliminar" con ConfirmModal hold-to-confirm (1.8s). E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
2026-05-25 feat(ux): polish pass · Emil Kowalski + Kyle Zantos motion principles
    Aplica la filosofía de design engineering de Emil Kowalski (animations.dev)
    y los principios de motion design de kylezantos/design-motion-principles
    sobre el sistema editorial existente.
    Motion tokens refinados:
    - --ease-out-strong (0.16, 1, 0.3, 1) · entries punchy
    - --ease-drawer (0.32, 0.72, 0, 1) · iOS drawer curve (Ionic)
    - --ease-in-out-emil (0.77, 0, 0.175, 1) · on-screen movement
    - --dur-press 160ms, --dur-tip 180ms, --dur-modal 280ms
    Press feedback (Emil's "must feel responsive"):
    - .button:active:not(:disabled) → transform: scale(0.97), 60ms snap
    - .icon-button:active → transform: scale(0.94)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
2026-05-25 feat(persistence): commit explícito en el ExportModal · nada se guarda hasta que el clínico confirme
    Cambio profundo del modelo de persistencia. Antes:
    - Al iniciar la adquisición se creaba una fila en sessions (vacía)
    - Cada 10s se insertaba en measurements
    - Al marcar evento, INSERT en session_events
    - Sesiones "basura" llenaban la nube si las mediciones salían mal
    Ahora:
    - TODO permanece en memoria local mientras la sesión está activa
    - El batch commit dispara SOLO cuando el clínico hace click en
    "Guardar paciente" o "Exportar PDF/CSV/TXT" con el switch
    "Guardar en BBDD" en ON
    - Si las mediciones estaban mal calibradas, basta con resetear y
    nada queda registrado en Supabas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
2026-05-25 fix(export): mover useState(committing) antes del early return
    Error #310 de React (Hooks can only be called in the body of a function
    component). El useState de `committing` quedó debajo de `if (!isOpen)
    return null`, lo cual viola las rules of hooks: el orden de hooks cambia
    entre el primer render (con isOpen=false) y el segundo (con isOpen=true),
    y React rompe todo el árbol → pantalla negra.
    Lo subo arriba del early return junto al resto de useState. Sin cambios
    de comportamiento.
2026-05-25 feat(firmware): variante ESP32-C3 con portal cautivo WiFi (WiFiManager)
    Nueva carpeta Chidori_ESP32C3_WiFiManager/ con un firmware idéntico al
    optimizado en lo eléctrico, pero que reemplaza las credenciales WiFi
    hardcodeadas por un portal cautivo de configuración.
    Características:
    - Primera vez: el ESP levanta el AP "Chidori-Setup" (abierto, sin password).
    Conectado desde el celular, abre el portal cautivo, elige red + tipea
    pass, guarda. Las credenciales viven en flash, NO en el código fuente.
    - Siguientes booteos: autoconecta a la red guardada en ~3 segundos.
    - Factory reset: mantener apretado el botón al boot por 5 s + 3 beeps de
    confirmación → borra credenciales y reinici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
    [Chidori_ESP32C3_WiFiManager.ino]
2026-05-25 feat(motion): NumberTicker + Shimmer + spring physics (estilo 21st.dev)
    Sube el nivel de motion sin recurrir a librerías que no encajan con el
    tono editorial. Mismo stack que 21st.dev usa internamente (framer-motion)
    pero seleccionando solo los patrones que sirven al instrumento clínico.
    Nuevos componentes:
    - NumberTicker · useSpring + useTransform con blur dinámico basado en
    velocidad del spring (truco de Emil Kowalski para mascarar el cross-fade
    entre dígitos). Stiffness/damping configurables por uso.
    - ShimmerSkeleton · placeholder con highlight deslizante. Animación pura
    CSS sobre background-position (GPU-friendly). Variante de rows con
    ancho aleatorio en la última líne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
2026-05-25 fix(NumberTicker): sacar el filter blur · los números se veían borrosos
    El "blur trick" estaba mal implementado: accedía a `spring.velocity` que
    no existe como prop directa en MotionValue (en framer-motion hay que usar
    `useVelocity(spring)` para eso). El fallback `?? motionValue` terminaba
    calculando el blur proporcional al VALOR del número (147.90) en lugar de
    a la velocidad del spring, dejando los KPIs permanentemente borrosos.
    Para contexto clínico la prioridad es legibilidad > efecto. El roll
    suave del spring ya da el feel deseado sin necesidad de mascarar el
    cross-fade con blur. Si queremos reintroducir el efecto en el futuro,
    hay que usar useVelocity con un threshold mucho más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
2026-05-25 feat(motion): Sparklines en KPIs + MorphingDialog en fila de sesiones (21st.dev)
    - Sparkline component (SVG + motion.path con spring pathLength, head animado)
    - StatsGrid reusa buffer de RealTimeCharts (zHistory/rateHistory, ventana 40)
    - AdminView: motion.button con layoutId compartido row ↔ SessionDetailModal,
    LayoutGroup + AnimatePresence para morph fluído al abrir/cerrar
2026-05-25 feat(mobile): pasada responsive completa · MobileMenu + breakpoints
    Adapta Chidori a phones/tablets sin sacrificar la densidad informativa
    que el clínico necesita en desktop. Sin agregar dependencias.
    Nuevo componente MobileMenu:
    - Drawer lateral idéntico en estilo al SettingsPanel · solo visible a
    ≤720px vía CSS (no se renderiza en desktop, pero el JS sí).
    - Items con icono + label + hint + accessory opcional · variante danger.
    - Sections para agruparlos · sticky head con brand + identidad.
    - Esc cierra, body scroll lock mientras está abierto.
    Layout responsive en index.css:
    - @media (max-width: 720px) · phones
    - @media (max-width: 760px) · tablets pequeñas (bladder)
    - @me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
2026-05-26 fix(baseline): warmup gate firmware + mediana en frontend
    Bug detectado: la primera medición que llega del ESP es un transitorio
    inestable (size_m=1 en el moving average) y quedaba capturada como
    "Referencia inicial" del paciente. Eso distorsiona el cambio total, el
    %, y el umbral porcentual de alarma. Ejemplo real: Z basal = 26.20 Ω
    cuando el valor real era ~100 Ω · cambio aparente +261%.
    Fix en dos capas:
    1. Firmware (Chidori_ESP32C3_WiFiManager + Optimizado):
    - Nuevo WARMUP_MUESTRAS = 5
    - adquirir_y_promediar() ahora descarta las primeras 5 muestras del
    moving average antes de transmitir o capturar Z_ref. El frontend
    recibe el primer dato con al menos 5 × 256 = 1280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
    [Chidori_ESP32C3_Optimizado.ino, Chidori_ESP32C3_WiFiManager.ino]
2026-05-26 fix(firmware): desactivar WiFi power save · paquetes llegaban en ráfagas
    Diagnóstico desde un export TXT real: los timestamps mostraban puntos
    agrupados en clusters cada 10-15 segundos en lugar de cada 500 ms. El
    ESP estaba acumulando paquetes en el buffer WiFi y los enviaba en burst.
    Causa: ESP32 entra por default en WIFI_PS_MIN_MODEM (ahorro de batería).
    El modem se duerme entre beacons, y como el DTIM del router puede ser
    cualquier valor (típico 1-10), los paquetes salientes esperan hasta el
    próximo "awake window". Bajo RSSI marginal (-75 dBm), el comportamiento
    se agrava porque las retransmisiones se acumulan.
    Fix · dos llamadas post-conexión WiFi:
    - WiFi.setSleep(false) ·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
    [Chidori_ESP32C3_Optimizado.ino, Chidori_ESP32C3_WiFiManager.ino]
2026-05-26 fix(firmware): sacar alarma local · el frontend es la única autoridad
    El firmware estaba disparando alarma con su propio UMBRAL = -1.5 dB
    hardcodeado, ignorando la configuración del clínico en la UI. Si el
    switch "Activar alarma" estaba apagado en el dashboard, el firmware
    igualmente entraba en estado ALARMA y prendía el buzzer físico cuando
    la atenuación bajaba del threshold interno.
    Además, la evaluación se hacía en el switch del loop principal, que
    corre miles de veces por segundo. Eso significaba que Alarm_counter
    decrementaba por iteración del loop, no por nueva muestra · suficiente
    para disparar alarma con caídas mínimas (~2-3%) en milisegundos.
    Fix: el firmware ahora a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
    [Chidori_ESP32C3_Optimizado.ino, Chidori_ESP32C3_WiFiManager.ino]
2026-05-26 fix(AD9833): secuencia oficial de init + transfers 8-bit MSB first
    Bug detectado al diagnosticar ausencia de señal 50 kHz en osciloscopio:
    la secuencia de inicialización del AD9833 sacaba el chip del modo RESET
    ANTES de configurar la frecuencia, dejando el DDS en estado indefinido.
    Secuencia anterior:
    1. CMD_RESET (0x2100 · RESET=1, B28=1)
    2. CMD_B28 (0x2000 · RESET=0) ← ¡bug! sale de reset antes de tiempo
    3. FREQ0 LSB
    4. FREQ0 MSB
    5. PHASE0
    6. CMD_EXIT_RESET_SINE
    Secuencia correcta según AD9833 datasheet + AN-1070:
    1. 0x2100 (RESET=1, B28=1) · mantiene salida en cero
    2. FREQ0 LSB
    3. FREQ0 MSB
    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
    [Chidori_ESP32C3_Optimizado.ino, Chidori_ESP32C3_WiFiManager.ino]
2026-05-29 fix(wifi): remover setTxPower(19.5dBm) · brown-out del USB CDC
    Causaba el síntoma "not connected" cada vez que se desconectaba y
    reconectaba el USB. TxPower al máximo dispara picos de >200mA pico al
    transmitir, que con cables USB de resistencia marginal generan caída
    de voltaje suficiente para resetear el ESP. Eso desconecta el USB CDC
    nativo del ESP32-C3 y macOS pierde el dispositivo.
    WiFi.setSleep(false) se mantiene · ese es el que arregla el burst de
    paquetes (el power save mode acumulaba TX en cola).
    Default TxPower del core (~11-15 dBm) alcanza para RSSI hasta -75 dBm.
    En este proyecto el RSSI medido es -57 a -60 dBm, mucho margen.
    Aplicado en ambos firmwares (WiFiManager + Opti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
    [Chidori_ESP32C3_Optimizado.ino, Chidori_ESP32C3_WiFiManager.ino]
2026-05-29 chore: mover Pruebas_PFC.ino a carpeta (estructura Arduino)
    Arduino IDE requiere que cada sketch viva en una carpeta con el mismo
    nombre que el .ino. Sin esto, abrir el archivo desde IDE lo movía
    automáticamente a /tmp con cada apertura.
2026-05-29 fix(wifi): portal AP con password WPA2 · macOS rechazaba redes abiertas
    macOS Sonoma/Sequoia bloquea o tira la conexión a APs sin password por
    seguridad, con tira el mensaje "No se pudo conectar a la red 'Chidori-Setup'".
    Con password (WPA2) conecta sin problemas y mantiene la conexión estable
    mientras se configura el WiFi destino.
    Password: chidori123 (mínimo 8 chars requerido por WPA2)
    [Chidori_ESP32C3_WiFiManager.ino]
2026-06-10 feat(firmware): WiFiManager edición robusta · transmisión en tiempo real confiable
    - Heartbeat WS 15s/3s/2: purga clientes fantasma que frenaban broadcastTXT
    - Reconexión WiFi runtime no bloqueante con backoff 5-30s + reboot preventivo
    - TX power 8.5 dBm (fix antena C3 Super Mini + brown-out USB CDC)
    - AD9833 init antes del WiFi + re-init defensivo en cada START
    - Scheduler de muestreo sin ráfagas (re-sync si el loop se atrasa)
    - Sin String en camino crítico (snprintf) · diagnóstico cada 10s + cmd STATUS/PING
    [Chidori_ESP32C3_WiFiManager.ino]
2026-06-11 feat(ui): rediseño v3 + lectura robusta congruente con firmware + roles admin
    Dashboard:
    - Arquitectura nueva: header mínimo con menú ⋯, barra de comando
    (control primario + cronómetro), grid de monitoreo con vejiga hero
    y resumen de alarma, setup en tabs Configuración/Eventos.
    - Gráficos fusionados en una card con toggle Impedancia/dZdt.
    - Readout jerárquico de 3 celdas (hero + basal + tasa).
    Robustez de lectura (alineada al protocolo del ESP32-C3 WiFiManager):
    - Router de mensajes WS: clasifica numérico vs STATUS/PONG con Number()
    estricto en vez de confiar en parseFloat→NaN.
    - sanitizeZ: límites de plausibilidad + rechazo de spikes con histéresis.
    - Reconciliación de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
2026-06-11 fix(ui): hardening post-assessment · updaters puros, decimación, backup anti-F5, watchdog de señal
    - handleIncomingData: tasa calculada sobre buffers ref síncronos, fuera de
    los updaters de setState (StrictMode duplicaba puntos en rateData).
    - Decimación LTTB en el gráfico (Chart.js decimation, 500 muestras sobre
    1000 puntos): sesiones de horas sin degradar el render; dataset completo
    intacto para export y cloud commit.
    - Backup de sesión a localStorage cada 30 s midiendo + al pausar; banner
    de recuperación al volver de un F5/crash que restaura en pausa con el
    cronómetro coherente. Expira a las 24 h; se limpia en reset/descartar.
    - Watchdog de señal congelada: >3 s sin da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
2026-06-26 Placa actualizada
    [BOM_CHIDORI.xlsx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]
2026-07-24 (DOC) Corrección de nombres
2026-07-24 CI: build de Windows
2026-07-24 UI: conexion simplificada + aviso de actualizacion (v1.1.0)
2026-07-25 Eventos de desconexion/reconexion + firma ad-hoc mac (v1.2.0)
2026-07-29 v1.3.0: tension de lectura, basal manual, ventanas y zoom, notas de sesion, efectos UI
2026-07-29 v1.4.0: microcortes con banda en el grafico, tipografia Montserrat + Climate Crisis, simulador de corte
2026-07-31 v1.5.0: protocolo experimental, fix de paginacion, volumen en dB
2026-08-03 v1.6.0: cache de pacientes offline, mediana y ADC calibrado en firmware
2026-08-11 v1.6.1: tension de lectura medida en A0 en vez de reconstruida
2026-08-14 Agregar escrito del proyecto final de carrera
2026-08-14 Eliminar seccion de electrodos del marco teorico
2026-08-15 v1.6.2: reiniciar conserva paciente y basal, diagnostico y limpieza de firmware
2026-08-21 v1.7.0: estimadores robustos de Z y reloj del equipo en el protocolo
    Basal, Z final y tasa pasan a calcularse por mediana sobre ventanas de
    tiempo en vez de sobre muestras sueltas, y la alarma se evalua sobre la
    tendencia con persistencia de 30 s. Sobre la sesion del 20-ago la tasa
    pasa de un rango de -576..+5808 ohm/min de puro ruido a -0,30..+0,40, y
    la alarma deja de dispararse 18 minutos antes de tiempo por un
    movimiento del paciente.
    El firmware agrega su millis() y un numero de secuencia al mensaje
    (<Z> <Vpp> <Vadc> <t_ms> <seq>): cada muestra queda ubicada en el
    instante en que se midio y no en el que llego, las muestras perdidas se
    cuentan exacto por salto de secuencia (288 microcor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
2026-08-25 cambio de un valor de resistencia kicad
    [PCB PFC.kicad_sch]
2026-09-04 cambio R amp hw
    [PCB PFC.kicad_sch]
2026-09-04 Z con constante de calibracion medida en vez de ganancias de diseno
    El firmware calculaba Z = Vpp / (I * G) con I = 288 uA y G = 200, ambos
    derivados de constantes de diseno. Ninguno de los dos era el valor real.
    G = GANANCIA_HIGH_PASS * GANANCIA_LOW_PASS * GANANCIA_INA = 10 * 4 * 5
    solo contaba U5B, U4B y el INA122. La cadena de recepcion tiene ademas
    U4A, U4C y U4D, que no aparecian en ninguna constante. Y el 4 de U4B era
    la relacion resistiva 2k/500, valida en continua: a 50 kHz la reactancia
    de CHP2 (1,5 n -> 2,1 kohm) domina sobre R6 (500 ohm) y esa etapa queda
    en ~0,92. El unico termino correcto era el x5 del INA122, que con Rg
    abierto da exactamente 5 por su formula G = 5 + 200k/Rg.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
    [Chidori_ESP32C3_WiFiManager.ino]
2026-09-04 Versionar la calibracion en Supabase y guardar la continua cruda de A0
    El cambio de constantes del commit anterior deja las sesiones ya guardadas
    en la escala vieja: sobreestiman Z ~4,4x en valor absoluto. Esto agrega la
    migracion para poder mezclarlas con las nuevas sin corromper el dataset.
    CRITERIO: no se toca ni un dato existente. `impedance` es el unico registro
    de lo que midio el equipo y las sesiones son irrepetibles. La correccion se
    expone en vistas; las tablas quedan intactas.
    sql/calibracion.sql · siete pasos idempotentes, cada uno con su consulta de
    verificacion, pensados para correr de a uno en el SQL Editor:
    1. tabla `calibrations`: la calibracion pasa a ser un objeto tra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
2026-09-04 Reescalar las sesiones guardadas en las tablas, conservando el original
    Alternativa a leer todo por vistas. AdminView lee sessions, measurements y
    session_events directo de las tablas, asi que apuntar la app a las vistas
    implicaba tocar cinco lugares y renombrar columnas en graficos y exportador.
    Pisar las tablas da el mismo resultado con menos superficie de error.
    Pisar es seguro porque la conversion es afin e invertible, y porque antes de
    pisar se copia el valor original a columnas _raw. Nada se pierde.
    Los dos riesgos reales de pisar quedan cubiertos:
    - Correrlo dos veces reescalaria dos veces. Resuelto: la conversion nunca
    se aplica sobre el valor ya convertido, siempre se recal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
2026-09-04 sql: un solo archivo de calibracion, unificado y probado
    Reemplaza calibracion.sql + reescalar.sql por un unico sql/calibracion.sql
    que se corre entero de una vez. Al reescalar las tablas las vistas _cal
    sobraban: menos objetos, menos que pueda salir mal.
    Probado contra PostgreSQL 16 con una maqueta del esquema. Diez casos:
    1. base limpia: 20,10 -> 4,6179 y 7,06 -> 1,9737, igual al calculo a mano
    2. idempotencia: cinco corridas extra no mueven un valor
    3. base ya flasheada: las sesiones nuevas quedan intactas
    4. base donde ya corrieron los scripts anteriores: no vuelve a reescalar
    5. sin tabla subjects: la vista del dataset igual se crea
    6. eventos kind='gap': conservan los seg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
2026-09-10 Actualización del esquemático
    [PCB PFC.kicad_sch]
2026-09-16 Recalibracion rev 3 tras ajustar la ganancia del Howland y los filtros
    Banco del 15/09/2026, placa #1. Cambios de hardware: RfAD1 8k, rhpad1
    500->1k, R_How 10k->8,06k, R8 8,2k, CHP1 y CHP2 cambiados.
    Mediciones (todo pico a pico, tetrapolar):
    outAD ................. 340 mVpp INAout (U5A) .... 14 mVpp
    U3A ................... 3,22 Vpp U4 pin 14 ....... 1450 mVpp
    FesOut+ ............... 188 mVpp Vadc en A0 ...... 556 mV
    I = V_U3A / R_How = 3,22 / 8060 ......... 399,5 uA pp
    ganancia post-INA = 1450 / 14 ........... 103,6
    ganancia total = 5 x 103,6 .............. 517,9
    K_CAL ................................... 0,20689
    deficit del detector = 1450/2 - 556 ....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
2026-09-16 rev 3 confirmada en banco: U4C era 330 mVpp, no 830
    Confirmaciones del 16/09 sobre la hoja del 15/09:
    - INAout reconfirmado en 14 mVpp -> K_CAL = 0,20689 queda como esta. Era
    el dato del que dependia un factor 1,8x.
    - U4 pin 8 son 330 mVpp, no 830. Con eso la cadena cierra entera: U4C
    atenua a 0,647, como corresponde a un pasabajos RC seguido de un buffer.
    Con 830 habria ganado, que es imposible.
    - J5 no se movio.
    De la cadena ya coherente se deducen dos valores de componente que la hoja no
    deja leer bien:
    - U4C atenua a 0,647 -> R8*CLP2 ~ 3,75 us -> con R8=8,2k, CLP2 ~ 457 pF y
    no los 270 pF impresos.
    - U4D gana 4,39 -> con R10=10k pide R9 ~ 2,3k: el "22K" de la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
2026-09-16 El 8,06k del Howland era una lectura en circuito: K_CAL 0,20689 -> 0,16675
    Las cuatro resistencias del Howland son 10 k, no 8,06 k. El 8,06 k anotado en
    la hoja es una lectura EN CIRCUITO: un ohmetro mide todo lo que hay entre sus
    dos puntas, o sea la resistencia en paralelo con cualquier otro camino del
    circuito, y por eso en circuito siempre lee de menos. El componente no cambia
    de valor al conectarlo; cambia lo que ve el instrumento.
    Midiendo R1how1 entre la salida de U3A y la entrada - de U3B, el camino
    paralelo es:
    U3A out --RfAD1--> U3A(-) --RiAD1--> outAD --rhpad1--> GND
    GND --R3how1--> FesOut+ --R4how1--> U3B out --R2how1--> U3B(-)
    o sea RfAD1 + RiAD1 + rhpad1 + 3x10k. Con R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
2026-09-16 Cadena completa: el modelo reproduce lo medido y aparece el error real
    Con CHP1=20n, CHP2=10n, R4=337 y R5=500 confirmados, el modelo nodal
    reproduce la cadena medida. Eso permite despejar los dos capacitores que
    faltaban y da por cerrado el esquematico:
    CLP1 = 4,7 n (despejado de la ganancia de U4A: da 4,60 n, el valor del
    esquematico, no los 100 p del BOM)
    CLP2 = ~470 p (despejado de la atenuacion de U4C: da 458 p, no los 270 p
    impresos; o se cambio sin anotar, o los 330 mVpp de U4C
    estan bajos)
    etapa modelo medido desvio
    U5B 9,84 11,29 -12,9 %
    U4A 1,005 1,013 -0,8 %
    U4B 3,47 3,19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
    [Chidori_ESP32C3_WiFiManager.ino]
2026-09-16 KiCad: valores confirmados en banco (CHP1, CHP2, R8, RiAD1, INA122)
    Cinco valores que estaban confirmados sin ambiguedad:
    CHP1 4.7n -> 20n confirmado por Luca
    CHP2 1.5n -> 10n confirmado por Luca
    R8 10k -> 8.2k anotado en la hoja de banco del 15/09
    RiAD1 500 -> 1k nota de la hoja: "Cambio RiAD1 500 -> 1K"
    U1 INA128 -> INA122 el chip real; el BOM mandaba a comprar el equivocado
    El lib_id de U1 sigue siendo Amplifier_Instrumentation:INA128. Mismo pinout
    SOIC-8, asi que la placa y el footprint no cambian, pero el valor que se ve
    en el esquematico y el que sale al BOM ahora dicen INA122, que es lo que
    importa para no volver a comprar el ch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
    [PCB PFC.kicad_sch]
2026-09-16 v1.8.0: el equipo reporta su calibracion y la sesion queda trazable
    Hasta ahora la app no tenia forma de saber con que constantes midio el ESP.
    La sesion se etiquetaba con el default de la base: si se flasheaba un firmware
    viejo por error, el dato quedaba guardado con la escala equivocada y nadie se
    enteraba. Es la clase de problema que nos costo un dia entero de auditoria.
    FIRMWARE
    El mensaje STATUS lleva ahora kcal y vdet:
    "STATUS estado=... rssi=... heap=... Z=... v=... kcal=0.16675 vdet=0.169"
    APP
    Dashboard parsea kcal/vdet en applyDeviceStatus, los muestra en el panel de
    diagnostico y los manda con la sesion. Si el firmware es viejo y no los
    reporta, el panel lo dice en vez de disim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
    [Chidori_ESP32C3_WiFiManager.ino]
2026-09-16 v1.8.0: calibracion medida, trazabilidad de la escala y crudo de A0
    Los ohms de esta version no son comparables con los de la 1.7.0: la escala
    pasa de constantes de diseño a constantes medidas en banco. Conversion para
    reportes viejos: Z_nueva = 0,3454*Z_vieja - 0,3718 (absolutos) y solo el
    factor para diferencias.
    El firmware reporta su K_CAL en el STATUS y la app etiqueta cada sesion con
    la calibracion que realmente la midio. El PDF ahora dice con que se midio.
    Se guarda la continua cruda de A0.
    Ver Programacion_UI_Micro/UI_REACT/RELEASE_v1.8.0.md
    [PCB PFC.kicad_sch]
2026-09-22 Corregir saltos de linea de la tabla de ganancias comparadas
2026-09-22 Completar salto de linea en la ultima fila de la tabla de ganancias
2026-09-22 Corregir R4 a 300 ohm y recalcular ganancias, amplitudes y Bode
2026-09-22 Revertir cambio de R4 a 300 ohm (volver a 337 ohm)
2026-09-25 package-lock: sincronizar la version con package.json (1.8.0)
    npm install actualizo el campo version del lockfile, que habia quedado en
    1.7.0 despues del bump. Sin cambios de dependencias.
    Claude-Session: https://claude.ai/code/session_01LfmR26CcbFRkuntFbsCN2c
2026-09-27 comentario en kicad y resist
    [PCB PFC.kicad_sch]
2026-09-28 R9 1,1k: calibracion por placa y correccion de P-004 s9
    El 27/09 se cambio R9 de 2,2k a 1,1k en una placa (U4D x4,5 -> x9,1) y la
    sesion 9 de P-004 se midio con el firmware todavia en rev 3: quedo al doble.
    - Firmware: R9_OHM elige la calibracion segun la placa. 2200 -> rev 3
    (K_CAL 0,16675, medida); 1100 -> rev 4 (K_CAL 0,33350, derivada x2).
    Otro valor no compila. El boot imprime R9 y la calibracion en uso.
    - SQL: calibracion 4 en el catalogo y columna calibration_hw_id (la placa
    real) separada de calibration_id (lo que calculo el firmware). Cada sesion
    queda en ohms de su placa. P-004 s9 pasa a placa 4 (valores / 2); el resto
    no cambia. Idempotente; si no encuentra la s9 corta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
2026-09-28 Interfaz nueva: placa 3D en el inicio, lecturas y paneles plegables, alarma audible
    - Pantalla de inicio con la placa en 3D (export GLB de KiCad optimizado con
    scripts/optimizar-pcb.mjs, ~0,8 MB); se ilumina con el equipo enlazado.
    - La columna de luz pasa a ser el fondo de toda la app; midiendo se atenua
    y baja a 24 fps para sesiones largas. Variante "tinta" para tema claro.
    - Al iniciar, las tarjetas de la pantalla de inicio vuelan a su lugar en el
    dashboard (FLIP con Web Animations, sin dependencias nuevas).
    - Lecturas: tres celdas del mismo ancho, sin sparklines; Volumen estimado y
    Alarma como celdas plegables que abren un panel al costado del grafico.
    - Configuracion y Eventos p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
2026-09-28 KiCad: ruta del export 3D, fuera el GLB pesado y un backup viejo
    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
2026-09-28 v1.9.0: interfaz nueva y calibracion por placa
    - Firmware: R9_OHM elige la calibracion segun la placa (2,2k rev 3 medida,
    1,1k rev 4 derivada). SQL rev 4 corrige P-004 s9 (medida al doble).
    - Interfaz nueva: placa 3D en el inicio, lecturas y paneles plegables,
    alarma audible, tipografias embebidas.
    - release_v1.9.0.sh verifica que .env.local no tenga valores de ejemplo
    antes de compilar y sube el .dmg al release si esta `gh`.
    Ver Programacion_UI_Micro/UI_REACT/RELEASE_v1.9.0.md
    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
2026-10-09 Rev 5: R9 es 1,2k, calibracion medida de esa placa (K 0,342 · Vd 0,230)
    Mediciones del 09/10 sobre Luca: corriente 328 uA (U3 pata 1 / 10k, descarta
    los 400 uA), cadena U5B..U4D x20,8, deficit del detector 0,230 V. R9 de la
    placa modificada es 1,2k (SMD 1201), no 1,1k.
    - Firmware: R9_OHM 1200 (rev 5, K 0,342, Vd 0,230) o 2200 (rev 3). El
    V_DETECTOR pasa a ser por placa. Se quita 1100: esa placa no existe.
    - SQL: calibracion 5 medida y calibrations.hw_id. Las sesiones con el
    firmware "1,1k" (4) pasan solas a la placa 5; P-004 s9 pasa a placa 5
    (basal 7,55 ohm). Reclasifica por K_CAL reportado las sesiones que
    entraron antes de que su calibracion estuviera en el catalogo.
    Co-Authore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
2026-10-10 Pacientes sin cambiar de WiFi: descarga anticipada y selector instantaneo
    La lista de pacientes se descarga sola al abrir la app con internet y se
    refresca cada 10 min, al volver el foco y al volver internet (pausado
    mientras se mide). En la red del Chidori se elige de lo guardado.
    - usePatientsPrefetch: guarda pacientes, campos y cuantas sesiones tiene
    cada paciente.
    - PatientGate muestra lo guardado al instante y busca cambios en segundo
    plano; el paso "sesion N" no espera a la red.
    - Toda consulta interactiva a Supabase tiene tope de 5 s (conTimeout): sin
    internet la app cae al cache en vez de colgarse.
    - "Sesion N" suma las sesiones medidas offline que esperan en la cola.
    - La pan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
2026-10-10 Base de datos: mantenimiento seguro, permisos y esquema versionado
    - sql/mantenimiento/01-06: diagnostico, respaldo completo en el esquema
    respaldo, vistas en solo lectura y fuera de la clave publica,
    v_dataset_modelo, numeracion de sesiones con turno por paciente e indice
    unico, y exportacion del esquema. Ningun paso modifica ni borra datos.
    - sql/esquema_base.sql: definicion completa de la base de produccion
    (10-10-2026), para reconstruir un proyecto vacio.
    - pacientes_y_campos.sql y calibracion.sql re-aplican los permisos al
    recrear vistas; las politicas de pacientes usan is_approved_user().
    - protocolo_experimental.sql marcado obsoleto: se frena si se corre.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
2026-10-10 Tesis: seccion Base de datos y diagrama entidad-relacion
    - main.tex: subsubseccion Base de datos (modelo, variables configurables,
    trazabilidad de calibracion, integridad, seguridad con RLS, vista del
    dataset, respaldo). Figura apaisada: se agrega el paquete rotating.
    - figuras/der_base_datos.drawio (editable en draw.io), .pdf (el que usa la
    tesis), .png y generar_der.py para regenerarlo.
    Claude-Session: https://claude.ai/code/session_01DYM2RHnMo66GqpX16YJBpZ
2026-10-10 v1.9.1: pacientes sin cambiar de WiFi y calibracion rev 5
    - La lista de pacientes se descarga sola al abrir la app y se elige en la
    red del Chidori sin internet (ver RELEASE_v1.9.1.md).
    - Firmware y base con la calibracion medida de la placa de R9 = 1,2k.
    - release_v1.9.1.sh: solo exige limpio el codigo de la app; cambios en la
    tesis, el KiCad o sql/ no frenan el release.
    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
2026-10-20 v1.10.0: edición de sesiones guardadas en el panel admin
    Editor de curva no destructivo en el detalle de cada sesión: recorte de
    inicio y fin (re-cera el tiempo), tramos del medio sacados y rellenados
    con PCHIP sobre Z y Vadc (apoyo en medianas de 5 s a cada lado), suavizado
    centrado media/mediana de n muestras, basal y final a mano o con las reglas
    de siempre, eventos corregidos (agregar, mover, borrar, ml) y comentarios
    anclados a un instante o tramo. La editada pasa a ser la principal; la
    original queda intacta y "Volver al original" borra la edición.
    - Apta / no apta por sesión (default apta), con nota opcional.
    - Descargas PDF/CSV/TXT: se elige original o editada; la editada dice q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
2026-10-20 Release v1.10.0: notas y script de publicación
    - MD releases/RELEASE_v1.10.0.md: edición de sesiones, apta / no apta,
    descargas original o editada.
    - release_v1.10.0.sh (antes release_v1.9.1.sh): pide confirmar
    sql/edicion_sesiones.sql y lee las notas de "MD releases/".
    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
2026-10-21 Principios del EDA y algo de escritura
2026-10-24 Rev 6: placa 3.1 en todas las placas (K 0,01800 · Vd 0,260)
    Placa 3.1: R2 10k -> 1,5k (U5B x1,5), R9 -> 2k y R10 10k -> 4,7k
    (U4D x2,35). Ganancia total 53,2, ~20 veces menos: rango ~29 a ~250 ohm.
    Validada con una resistencia fija de 120 ohm: pata 14 2,160 Vpp, Vout
    820 mV -> K = 2,160/120 = 0,01800 (= 338 uA x 53,2) y deficit 0,260 V.
    - Firmware: PLACA reemplaza a R9_OHM (cambian tres resistencias). Default
    PLACA_3_1; quedan PLACA_R9_1K2 (rev 5) y PLACA_R9_2K2 (rev 3).
    - calibracion.sql rev 6: calibracion 6 = placa 3.1. La LISTA de placa
    modificada lleva tambien el firmware con que se midio cada sesion, asi
    sirve para sesiones de una 3.1 medidas con el firmware viejo.
    Co-Authored-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
2026-10-24 Rev 6: todas las sesiones a la escala de la placa 3.1
    La placa con la que se venia midiendo tenia un componente que no
    amplificaba: la ganancia real era mucho menor que la que suponia el
    firmware y la Z salia mucho menor. La medicion del 09/10 lo confirma:
    con U5B en x0,53 en vez de x10 la ganancia total da ~55, contra 53,2 de
    la placa 3.1 (K 0,0181 vs 0,0180).
    - calibrations.hw_id: todo firmware apunta a la 6 (linea TODAS). Queda
    comentada la alternativa de pasar solo la placa modificada (fw 4 y 5).
    - LISTA: P-004 s9 -> placa 6.
    - Probado en Postgres local: fw 4 7,03 -> 140,4 ohm; fw 5 6,65 -> 129,7;
    fw 3 8,73 -> 91,0; fw 1 25,65 -> 88,8. Eventos, tasa y ediciones se
    reescalan igual.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
2026-10-24 calibracion.sql: todas las sesiones son de la placa 1
    Confirmado: todas las sesiones guardadas se midieron con la placa 1 (la de
    la falla). El banco del 15/09 fue sobre la placa 3, ya modificada. Se quita
    la alternativa de reescalar solo firmware 4 y 5. Sin cambio de resultado.
    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
2026-10-25 actualizacion de firmware-->valores de 120ohms
2026-11-08 sacar redundancias de 3.xx
2026-11-08 EDA: calibracion por cargas, placa 3.1 y figuras en el repo
    - Calibracion del analisis: recta de banco por cargas (7,14 mV/ohm,
    -47 mV, R2 0,9988) en vez de la cal 6 de un solo punto. La placa 1
    antes del 27/09 (R9 2,2k) se multiplica ademas por 8,15/4,4. Con eso
    el mismo sujeto da el mismo Z basal con las tres configuraciones.
    - Placa 3.1 detectada por firmware rev 6 (config_hw, placa_fisica).
    - Piso de artefacto relativo (0,7 % de la tendencia) en vez de 0,05 ohm.
    - Peso tomado tambien de la ficha del paciente.
    - Figuras: nombre para sesiones sin numero y etiqueta de placa/escala.
    - salidas/figuras y salidas/resumen.md entran al repo para el equipo;
    datos/ y las tablas derivadas si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
2026-11-13 Corregido las notas de gus hasta el 12/11
2026-11-13 Añadida sección de carcasa
